Songyang-W/GridTapeStage_Scatha/docs/pinouts.xlsx

Sheet: DB-9 pinouts
 | Pin Number | Signal | Stepper wire | Shield Input | Shield | Shield Signal | CS | Chain Index | 0 direction | Enclosure Port
Top DB-9 | 1 | Feed, Pinch | Red | ST2 | Top | 2B | A2 | 0 | CCW | Top
 | 2 | Feed, Pinch | Blue | ST2 | Top | 1B | A2 | 0 | CCW | Top
 | 3 | Feed, Pinch | Black | ST2 | Top | 1A | A2 | 0 | CCW | Top
 | 4 | Feed, Pinch | Green | ST2 | Top | 2A | A2 | 0 | CCW | Top
 | 5 | NC
 | 6 | Feed, Reel | Red | ST2 | Bottom | 2B | D2 | 0 | CCW | Top
 | 7 | Feed, Reel | Blue | ST2 | Bottom | 1B | D2 | 0 | CCW | Top
 | 8 | Feed, Reel | Black | ST2 | Bottom | 1A | D2 | 0 | CCW | Top
 | 9 | Feed, Reel | Green | ST2 | Bottom | 2A | D2 | 0 | CCW | Top
Bottom DB-9 | 1 | Pickup, Pinch | Red | ST1 | Top | 2B | A2 | 1 | CCW | Bottom
 | 2 | Pickup, Pinch | Blue | ST1 | Top | 1B | A2 | 1 | CCW | Bottom
 | 3 | Pickup, Pinch | Black | ST1 | Top | 1A | A2 | 1 | CCW | Bottom
 | 4 | Pickup, Pinch | Green | ST1 | Top | 2A | A2 | 1 | CCW | Bottom
 | 5 | NC
 | 6 | Pickup, Reel | Red | ST1 | Bottom | 2B | D2 | 1 | CCW | Bottom
 | 7 | Pickup, Reel | Blue | ST1 | Bottom | 1B | D2 | 1 | CCW | Bottom
 | 8 | Pickup, Reel | Black | ST1 | Bottom | 1A | D2 | 1 | CCW | Bottom
 | 9 | Pickup, Reel | Green | ST1 | Bottom | 2A | D2 | 1 | CCW | Bottom

Sheet: 4 pin pinouts
 | Pin number | Signal | Buckpuck | Arduino | Load cell | Lemo Pin | Lemo Color
Left 4 pin | 1 | E+ |  |  | Red | 9 | Grey
(above USB) | 2 | E- |  |  | Black | 8 | Violet
 | 3 | A- |  |  | White | 7 | Blue
 | 4 | A+ |  |  | Green | 10 | White
Right 4 pin | 1 | 12V | V+ | -
 | 2 | 5V | REF
 | 3 | D3 | CTL | D3
 | 4 | GND | V- | GND

Sheet: 10pin Lemo
Pin | Wire color | Signal | Load Cell | 4 Pin connector
1 | Black
2 | Brown
3 | Red
4 | Orange
5 | Yellow
6 | Green
7 | Blue | A- | White | 3
8 | Violet | GND (E-) | Black | 2
9 | Gray | 5V (E+) | Red | 1
10 | White | A+ | Green | 4
