Songyang-W/GridTapeStage_Scatha/docs/BOM_191002.xlsx

Sheet: BOM
Part name | Quantity | CAD file | Drawing | Assembly | Type | Tested? | Info | Operation | Vender | Part Number | Quantity for 2 | Link | Package Cost | Units per package | Cost (for 1) | Packages for 2 | Cost | Ordered | When
chamber | 1 | chamber_v1 | chamber_v1 | piezo chamber | custom | yes | Al, 2 x 2.25 x 2.938 | machine |  |  | 2
chamber lid | 1 | chamber_lid_with_view | chamber_lid_with_view | piezo chamber | custom | yes | Al, 3/8 x 2 x 2.9063 | machine |  |  | 2
front left flange | 1 | front_left_xy_flange | front_left_xy_flange | piezo chamber | custom |  | Al, 1.6937 x 2 x 2.75 | machine |  |  | 2
piezo baseplate | 1 | piezo_baseplate | piezo_baseplate | piezo stack | custom | yes | Al, 0.049 x 0.669 x 1.181 | machine |  |  | 2
channel baseplate | 1 | channel_base_plate | channel_baseplate | piezo stack | custom | yes | Al, 0.0705 x 0.669 x 0.787 | machine |  |  | 2
load cell baseplate | 1 | load_cell_vertical_base_v2 | load_cell_vertical_base_v2 | tension sensor | custom | yes | Al, 0.295 x 0.570 x 0.875 | machine |  |  | 2
load cell adapter | 1 | tension_roller_mount_v2 | tension_roller_mount_v2 | tension sensor | custom | yes | Al, 0.25 x 0.5 x 0.647 | machine |  |  | 2
load cell rollers | 1 | tension_roller_v2 | tension_roller_v2 | tension sensor | custom | yes | Al, D0.25 x 0.5 | machine |  |  | 2
channel bottom | 1 | straight_stick_v2 | straight_stick_v2 | channel | custom | yes | Al, 1.575 x 0.6693 x 9.75 | machine |  |  | 2
tape clamp | 1 | tape_clamp | tape_clamp | channel | custom | yes | Al, 0.0787 x 0.315 x 9.75 | machine |  |  | 2
takeup reel flange | 1 | takeup_reel_flange | takeup_reel_flange | takeup | custom | yes | Al, 0.25 x 2.5 x 2.5 | machine |  |  | 2
takeup rest static insert | 1 | takeup_rest_insert | takeup_rest_insert | takeup | custom | yes | Al, D1.322 x 0.7874 | machine |  |  | 2
reel housing | 2 | reel_housing | reel_housing | reel housing | custom | yes | Al, 1.25 x 4.625 x 5.8956 | machine |  |  | 4
reel door | 2 | reel_door | reel_door | reel housing | custom | yes | Al, 0.25 x 4.625 x 5.8956 | machine |  |  | 4
reel flange | 2 | reel_housing_flange | reel_housing_flange | reel housing | custom | yes | Al, 0.25 x 2 x 2 | machine |  |  | 4
reel to qf flange | 2 | reel_housing_to_qf16_flange | reel_to_qf16_flange | reel housing | custom | yes | Al, 0.25 x 2 x 2 | machine |  |  | 4
reel blank flange | 4 | reel_housing_blank | reel_housing_blank | reel housing | custom | yes | Al, 0.25 x 1.25 x 2 | machine |  |  | 8
idle roller | 2 | roller | roller | reel housing | custom | yes | Al, D0.5 x 0.4478 | emachineshop |  |  | 4
pinch drive roller | 4 | drive_roller | drive_roller | pinch drive | custom | yes | Al, D0.82 x 0.315 | machine |  |  | 8
smaller pinch drive roller | 2 | drive_roller_smaller |  | pinch drive | custom | yes | Al, D0.81 x 0.315 | machine |  |  | 4
pinch drive plate | 2 | pinch_drive_clamp_short |  | pinch drive | custom | yes | Al, 0.125 x 1.1024 x 1.4824 | waterjet |  |  | 4
reel adapter | 2 | reel_adapter_screw_set_3f16 | reel_adapter_screw_set_3f16 | reel drive | custom | yes | Al, D1.675 x 0.5 | machine |  |  | 4
reel drive feedthrough clamp | 4 | ferrotec_clamp | ferrotec_clamp | reel drive | custom | yes | Al, 0.1875 x 1.1024 x 1.1024 | machine |  |  | 8
reel drive plate | 2 | reel_drive_clamp |  | reel drive | custom | yes | Al, 0.125 x 4.4973 x 5.167 | waterjet |  |  | 4
slip clutch shaft | 2 | shaft_adapter_5mm_1f4in | shaft_adapter_5mm_1f4in | reel drive | custom | yes | Al, D0.5 x 1 | machine |  |  | 4
takeup rest oring | 2 |  |  | takeup | oring |  | dash 122 | order | mcmaster | 9464K86 | 4 | http://www.mcmaster.com/#9464K86 | 11.63 | 50 | 0.2326 | 1 | 11.63
piezo chamber lid oring | 1 |  |  | piezo chamber | oring | yes | dash 036 | order | mcmaster | 9464K361 | 2 | http://www.mcmaster.com/#9464K361 | 4.75 | 10 | 0.475 | 1 | 4.75
front left to piezo oring | 1 |  |  | piezo chamber | oring |  | dash 027 | order | mcmaster | 9464K271 | 2 | http://www.mcmaster.com/#9464K271 | 10.76 | 50 | 0.2152 | 1 | 10.76
front left to scope oring | 1 |  |  | piezo chamber | oring |  | dash 028 | order | mcmaster | 9464K281 | 2 | http://www.mcmaster.com/#9464K281 | 10.49 | 50 | 0.2098 | 1 | 10.49
reel flange oring | 6 |  |  | reel housing | oring | yes | dash 027 | order | mcmaster | 9464K271 | 12 | http://www.mcmaster.com/#9464K271 | 10.76 | 50 | 0.2152 | 1 | 10.76
takeup flange oring | 1 |  |  | takeup | oring | yes | dash 219 | order | mcmaster | 9464K41 | 2 | http://www.mcmaster.com/#9464K41 | 11.25 | 25 | 0.45 | 1 | 11.25 |  |  | 92010A001
pinch drive oring | 4 |  |  | pinch drive | oring | yes | dash 018 square | order | mcmaster | 1170N29 | 8 | http://www.mcmaster.com/#1170N29 | 7.94 | 10 | 0.794 | 1 | 7.94 | 6448208 | 2016-03-22
reel housing door oring | 2 |  |  | reel housing | oring | yes | dash 048 | order | mcmaster | 9464K511 | 4 | http://www.mcmaster.com/#9464K511 | 2.23 | 2 | 1.115 | 2 | 4.46 | 6448208 | 2016-03-22
QF-25 clamp | 2 |  |  | piezo chamber | flange | yes |  | order | lesker | QF25-100-C | 4 | http://www.lesker.com/newweb/flanges/hardware_kf_clamps_machined.cfm?pgid=al2 | 8.25 | 1 | 8.25 | 4 | 33 | 6381132 | 160201
QF-25 centering ring | 3 |  |  | piezo chamber | flange | yes |  | order | lesker | QF25-100-SRV | 6 | http://www.lesker.com/newweb/flanges/hardware_kf_centeringrings.cfm?pgid=ss | 8.25 | 1 | 8.25 | 6 | 49.5 | 6381132 | 160201
QF-25 tee | 1 |  |  | piezo chamber | flange | yes |  | order | lesker | QF25-100-T | 2 | http://www.lesker.com/newweb/flanges/fittings_kf_tees.cfm?pgid=standardtee | 75 | 1 | 75 | 2 | 150 | 6381132 | 160201
QF-25 blank flange | 2 |  |  | piezo chamber | flange | yes |  | order | lesker | QF25-100-SB | 4 | http://www.lesker.com/newweb/flanges/flanges_kf_blank.cfm?pgid=flange1 | 9.3 | 1 | 9.3 | 4 | 37.2 | 6381132 | 160201
QF-25 bulkhead clamp | 1 |  |  | piezo chamber | flange | yes |  | order | lesker | QF25-100-BC | 2 | http://www.lesker.com/newweb/flanges/hardware_kf_clamps_bulkhead.cfm?pgid=al | 21.8 | 1 | 21.8 | 2 | 43.6 | 6381132 | 160201
QF-25 feedthrough (smaract) | 1 |  |  | piezo chamber | flange | yes |  | modify | lesker | QF25-100-SB | 2 | http://www.lesker.com/newweb/flanges/flanges_kf_blank.cfm?pgid=flange1 | 9.3 | 1 | 9.3 | 2 | 18.6 | 6381132 | 160201
QF-25 feedthrough (tension) | 1 |  |  | piezo chamber | flange | yes |  | modify | lesker | QF25-100-SB | 2 | http://www.lesker.com/newweb/flanges/flanges_kf_blank.cfm?pgid=flange1 | 9.3 | 1 | 9.3 | 2 | 18.6 | 6381132 | 160201
QF-16 viewport | 3 |  |  | reel housing | flange | yes |  | order | lesker | QF16-075-VP | 6 | http://www.lesker.com/newweb/flanges/viewports_kf_glass.cfm?pgid=0 | 100 | 1 | 100 | 6 | 600 | 6381132 | 160201
QF-16 blank | 3 |  |  | reel housing | flange | yes |  | order | lesker | QF16-075-SB | 6 | http://www.lesker.com/newweb/flanges/flanges_kf_blank.cfm?pgid=flange1 | 8.25 | 1 | 8.25 | 6 | 49.5 | 6381132 | 160201
QF-16 centering ring | 3 |  |  | reel housing | flange | yes |  | order | lesker | QF16-075-SRV | 6 | http://www.lesker.com/newweb/flanges/hardware_kf_centeringrings.cfm?pgid=ss | 6.5 | 1 | 6.5 | 6 | 39 | 6381132 | 160201
QF-16 bulkhead clamp | 3 |  |  | reel housing | flange | yes |  | order | lesker | QF16-075-BC | 6 | http://www.lesker.com/newweb/flanges/hardware_kf_clamps_bulkhead.cfm?pgid=al | 18.6 | 1 | 18.6 | 6 | 111.6 | 6381132 | 160201
tension sensor roller pin | 1 |  |  | tension sensor | fastener | yes | SS, 1/8 x 5/16 dowel pin | order | mcmaster | 90145A878 | 2 | http://www.mcmaster.com/#90145A878 | 7.34 | 50 | 0.1468 | 1 | 7.34
tension sensor adapter screws | 4 |  |  | tension sensor | fastener |  | SS, 0-80 x 1/4 FH | order | mcmaster | 91771A055 | 8 | http://www.mcmaster.com/#91771A055 | 9.01 | 100 | 0.0901 | 1 | 9.01
tension sensor mounting screws | 2 |  |  | tension sensor | fastener | yes | SS, 2-56 x 3/8 SHCS vented | order | mcmaster | 93235A079 | 4 | http://www.mcmaster.com/#93235A079 | 8.12 | 5 | 1.624 | 1 | 8.12 | 6448208 | 2016-03-22
piezo baseplate mounting screws | 4 |  |  | piezo chamber | fastener | yes | SS, 2-56 x 3/16 SHCS vented | order | mcmaster | 93235A076 | 8 | http://www.mcmaster.com/#93235A076 | 5.35 | 5 | 1.07 | 2 | 10.7 | 6448208 | 2016-03-22
piezo stack mounting screws | 4 |  |  | piezo chamber | fastener |  | SS, M1.6 x 4 mm FH | order | mcmaster | 91430A003 | 8 | http://www.mcmaster.com/#91430A003 | 8.7 | 25 | 0.348 | 1 | 8.7 | 6448208 | 2016-03-22
channel plate mounting screws | 2 |  |  | piezo chamber | fastener |  | SS, M2 x 3 mm FH | order | mcmaster | 92010A001 | 4 | http://www.mcmaster.com/#92010A001 | 4 | 100 | 0.04 | 1 | 4
channel mounting screws | 4 |  |  | channel | fastener |  | SS, 0-80 x 7/32 FH | order | mcmaster | 91771A040 | 8 | http://www.mcmaster.com/#91771A040 | 9.63 | 100 | 0.0963 | 1 | 9.63
front left to column screws | 4 |  |  | piezo chamber | fastener |  | SS, M6 x 10 SHCS low profile | order | mcmaster | 92855A610 | 8 | http://www.mcmaster.com/#92855A610 | 8.21 | 25 | 0.3284 | 1 | 8.21 | 6448208 | 2016-03-22
chamber to front left screws | 4 |  |  | piezo chamber | fastener |  | SS, M5 x 16 SHCS | order | mcmaster | 91292A126 | 8 | http://www.mcmaster.com/#91292A126 | 10 | 100 | 0.1 | 1 | 10
chamber lid screws | 4 |  |  | piezo chamber | fastener |  | SS, 6-32 x 1/2 FHSC | order | mcmaster | 92210A148 | 8 | http://www.mcmaster.com/#92210A148 | 4.36 | 100 | 0.0436 | 1 | 4.36
reel flange small screws | 16 |  |  | reel housing | fastener |  | SS, 4-40 x 3/8 FHSC | order | mcmaster | 92210A108 | 32 | http://www.mcmaster.com/#92210A108 | 3.35 | 100 | 0.0335 | 1 | 3.35 | 6448208 | 2016-03-22
reel flange large screws | 16 |  |  | reel housing | fastener |  | SS, 6-32 x 7/16 FHSC | order | mcmaster | 92210A114 | 32 | http://www.mcmaster.com/#92210A114 | 4.38 | 100 | 0.0438 | 1 | 4.38 | 6448208 | 2016-03-22
idle roller shoulder screw | 2 |  |  | pinch drive | fastener |  | SS, 4-40 x 1/8 x 5/8 shoulder screw | modify | mcmaster | 97345A104 | 4 | http://www.mcmaster.com/#97345A104 | 4.39 | 1 | 4.39 | 4 | 17.56 | 6448208 | 2016-03-22
pinch roller set screws | 4 |  |  | pinch drive | fastener |  | SS, 8-32 x 1/4 set screw vented | order | mcmaster | 91979A408 | 8 | http://www.mcmaster.com/#91979A408 | 7.1 | 10 | 0.71 | 1 | 7.1 | 6448208 | 2016-03-22
reel drive set screw | 2 |  |  | reel drive | fastener |  | SS, 8-32 x 1/4 set screw vented | order | mcmaster | 91979A408 | 4 | http://www.mcmaster.com/#91979A408 | 7.1 | 10 | 0.71 | 1 | 7.1 | 6448208 | 2016-03-22
reel hub screws | 6 |  |  | reel drive | fastener |  | SS, 2-56 x 1/2 SHCS | order | mcmaster | 92196A081 | 12 | http://www.mcmaster.com/#92196A081 | 5.72 | 100 | 0.0572 | 1 | 5.72 | 6448208 | 2016-03-22
reel door screws | 20 |  |  | reel housing | fastener | yes | SS, 4-40 x 3/8 SHCS | order | mcmaster | 92196A108 | 40 | http://www.mcmaster.com/#92196A108 | 3.98 | 100 | 0.0398 | 1 | 3.98 | 6448208 | 2016-03-22
ferrotec slamp screws | 16 |  |  | reel housing | fastener |  | SS, 2-56 x 5/16 FHSC | order | mcmaster | 92210A078 | 32 | http://www.mcmaster.com/#92210A078 | 6.22 | 100 | 0.0622 | 1 | 6.22
drive clamp screws | 6 |  |  | reel housing | fastener |  | SS, 4-40 x 3/8 SHCS | order | mcmaster | 92196A108 | 12 | http://www.mcmaster.com/#92196A108 | 3.98 | 100 | 0.0398 | 1 | 3.98 | 6448208 | 2016-03-22
nema 11 screws | 16 |  |  | reel housing | fastener | yes | SS, M2.5 x 6 BHSCS | order | mcmaster | 92095A458 | 32 | http://www.mcmaster.com/#92095A458 | 7.07 | 25 | 0.2828 | 2 | 14.14 | 6448208 | 2016-03-22
slip clutch set screws | 2 |  |  | reel drive | fastener |  | SS, 4-40 x 1/8 set screw | order | mcmaster | 92311A103 | 4 | http://www.mcmaster.com/#92311A103 | 4.21 | 100 | 0.0421 | 1 | 4.21 | 6448208 | 2016-03-22
takeup flange screws | 2 |  |  | takeup | fastener |  | SS, M4 x 10 FHSC | order | mcmaster | 92125A190 | 4 | http://www.mcmaster.com/#92125A190 | 7.23 | 100 | 0.0723 | 1 | 7.23
takeup flange wrench | 1 |  |  | takeup | tool |  | extended t-handle | order | mcmaster | 5334A42 | 2 | http://www.mcmaster.com/#5334A42 | 1.97 | 1 | 1.97 | 2 | 3.94 | 6448208 | 2016-03-22
stepper motors | 4 |  |  | motors | motors |  | nema 11 stepper | order | digikey | 1460-1072-ND | 8 | http://www.digikey.com/product-search/en?keywords=1460-1072-nd | 37.99 | 1 | 37.99 | 8 | 303.92 | 6390515 | 160208
tension sensor | 1 |  |  | tension sensor | sensor |  | 0-100g load cell | modify | phidgets | CZL639HD | 2 | http://www.phidgets.com/products.php?category=34&product_id=3139_0 | 7 | 1 | 7 | 2 | 14 | pcard | 160205
ferrotec feedthrough | 4 |  |  | reel housing | feedthrough | yes | rotary feedthroughs |  | ferrotec | 103073 | 8 | https://www.ferrotec.com/index.php?id=feedthrough_detail&vfp_id=34 | 600 | 1 | 600 | 8 | 4800 | 6382708 | 160202
piezo xy stack | 1 |  |  | piezo stack | motors |  | slc-1720-s-hv, in xy, with MCS | order | smaract | slc-1720-s-hv | 2 | http://smaract.de/index.php/products/slc17-positioners/slc-1720 | 9052.5 | 1 | 9052.5 | 2 | 18105 | 6382658 | 160202
load cell amplifier | 1 |  |  | electronics | electronics |  | load cell amplifier | modify | sparkfun | SEN-13230 | 2 | https://www.sparkfun.com/products/13230 | 9.95 | 1 | 9.95 | 2 | 19.9
microcontroller proto board | 1 |  |  | electronics | electronics |  | arduino protoshield | modify | sparkfun | DEV-11665 | 1 | https://www.sparkfun.com/products/11665 | 4.95 | 1 | 4.95 | 1 | 4.95
stepper motor driver shield | 2 |  |  | electronics | electronics |  | x-nucleo-ihm02a1 | modify | digikey | 497-16251-ND | 4 | https://punchout.digikey.com/scripts/DkSearch/dksus.dll?Detail&itemSeq=191838508&uq=635932000139947652 | 14.16 | 1 | 14.16 | 4 | 56.64 | 6432645 | 160310
power supply | 1 |  |  | electronics | electronics |  | 12V >3A supply | order | digikey | 237-1443-ND | 2 | http://www.digikey.com/product-detail/en/WSU120-3000/237-1443-ND/3094969 | 20.27 | 1 | 20.27 | 2 | 40.54 | 6390515 | 160208
power jack | 1 |  |  | electronics | electronics |  | barrel jack | modify | digikey | CP-065A-ND | 2 | http://www.digikey.com/product-search/en?keywords=CP-065A-ND | 2.54 | 1 | 2.54 | 2 | 5.08 | 6390515 | 160208
microcontroller | 1 |  |  | electronics | electronics |  | arduino | modify | digikey | 1050-1041-ND | 2 | http://www.digikey.com/product-detail/en/A000073/1050-1041-ND/3476357 | 21.54 | 1 | 21.54 | 2 | 43.08 | 6390515 | 160208
tension sensor cabling | 1 |  |  | electronics | electronics |  | 10 conductor wiring | modify | digikey | W410-50-ND | 1 | http://www.digikey.com/product-search/en?keywords=w410-50-nd | 64.63 | 1 | 64.63 | 1 | 64.63 | 6390515 | 160208
tension sensor feedthrough | 1 |  |  | electronics | electronics |  | lemo feedthrough | modify | mouser | 736-HGP2S310CLLPV | 2 | http://www.mouser.com/ProductDetail/LEMO/HGP2S310CLLPV/ | 102.14 | 1 | 102.14 | 2 | 204.28 | pcard | 160208
tension sensor connector | 1 |  |  | electronics | electronics |  | lemo plug | modify | mouser | 736-FFP2S310CLAC72Z | 2 | http://www.mouser.com/ProductDetail/LEMO/FFP2S310CLAC72Z/ | 70.11 | 1 | 70.11 | 2 | 140.22 | pcard | 160208
idle roller bearing | 4 |  |  | pinch drive | mechanics |  | 1/8 shaft 1/4 flanged bearing | order | mcmaster | 57155k205 | 8 | http://www.mcmaster.com/#57155K205 | 5.71 | 1 | 5.71 | 8 | 45.68 | 6448208 | 2016-03-22
pinch drive timing belt pulley | 2 |  |  | pinch drive | mechanics |  | 1/8 MXL 15 tooth 3/16 bore | modify | mcmaster | 1375K15 | 4 | http://www.mcmaster.com/#1375K15 | 9.81 | 1 | 9.81 | 4 | 39.24 | 6448208 | 2016-03-22
reel drive timing belt pulley | 1 |  |  | reel drive | mechanics |  | 1/8 MXL 15 tooth 3/16 bore | modify | mcmaster | 1375K15 | 2 | http://www.mcmaster.com/#1375K15 | 9.81 | 1 | 9.81 | 2 | 19.62 | 6448208 | 2016-03-22
slip clutch timing belt pulley | 1 |  |  | reel drive | mechanics |  | 1/8 MXL 20 tooth 1/4 bore | modify | mcmaster | 1375K21 | 2 | http://www.mcmaster.com/#1375K21 | 10.48 | 1 | 10.48 | 2 | 20.96 | 6448208 | 2016-03-22
pinch drive timing belt | 1 |  |  | pinch drive | mechanics |  | MXL 1/8" Width, 4" Outer Circle | order | mcmaster | 7887K12 | 2 | http://www.mcmaster.com/#7887K12 | 2.39 | 1 | 2.39 | 2 | 4.78 | 6448208 | 2016-03-22
reel drive timing belt | 1 |  |  | reel drive | mechanics |  | MXL 1/8" Width, 7.6" Outer Circle | order | mcmaster | 7887K19 | 2 | http://www.mcmaster.com/#7887K19 | 2.51 | 1 | 2.51 | 2 | 5.02 | 6448208 | 2016-03-22
slip clutch slip washers | 4 |  |  | reel drive | mechanics |  |  | order | mcmaster | 2797T1 | 8 | http://www.mcmaster.com/#2797T1 | 1.31 | 1 | 1.31 | 8 | 10.48 | 6448208 | 2016-03-22
slip clutch spring washers | 2 |  |  | reel drive | mechanics |  |  | order | mcmaster | 9714K28 | 4 | http://www.mcmaster.com/#9714K28 | 14.24 | 25 | 0.5696 | 1 | 14.24 | 6448208 | 2016-03-22
slip clutch shaft coller | 2 |  |  | reel drive | mechanics |  |  | order | mcmaster | 6157K12 | 4 | http://www.mcmaster.com/#6157K12 | 2.2 | 1 | 2.2 | 4 | 8.8 | 6448208 | 2016-03-22
tape camera | 1 |  |  | electronics | electronics |  | raspberry pi or m12 | order |  |  | 2 |  |  | 1 | 0 | 2 | 0
tape camera mount | 1 | picam_to_viewport_mount |  | tape camera | mechanics |  |  | 3d print |  |  | 2 |  | 0 | 1 | 0 | 2 | 0
light led | 1 |  |  | electronics | electronics |  |  | order | digikey |  | 2 |  |  | 1 | 0 | 2 | 0
light heatsink | 1 |  |  | electronics | electronics |  |  | order | digikey | 345-1105-ND | 2 | http://www.digikey.com/product-detail/en/882-100AB/345-1105-ND/2640528 | 2.34 | 1 | 2.34 | 2 | 4.68 | 6390515 | 160208
light driver | 1 |  |  | electronics | electronics |  |  | order | digikey | 788-1096-ND | 2 | http://www.digikey.com/product-detail/en/3021-D-I-700/788-1096-ND/3114413 | 16.99 | 1 | 16.99 | 2 | 33.98 | 6390515 | 160208
tc led mount | 1 | tc led mount |  |  | electronics |  |  | 3d print |  |  | 2 |  | 0 | 1 | 0 | 2 | 0
case | 1 |  |  | electronics | electronics |  |  | modify | digikey | HM856-ND | 2 | https://punchout.digikey.com/scripts/DkSearch/dksus.dll?Detail&itemSeq=193471005&uq=635950280810903346 | 7.94 | 1 | 7.94 | 2 | 15.88

Sheet: Piezo Chamber
Part name | Info | Quantity | CAD file | Modification? | Vender | Part Number | Link | Package Cost | Units per package | Cost (for 1) | Cost | Ordered | When
chamber | Sheet 2 1/2 x 3 x 4 Al | 1 | chamber_v1 | Yes | mcmaster |  |  |  | 1 |  | #VALUE! | Yes | 150326
chamber lid | Sheet 3/8 x 2 1/2 x 6 Al | 1 | chamber_lid_with_view | Yes | mcmaster |  |  |  | 2 |  | #VALUE! | Yes | 150326
piezo baseplate | Sheet 1/8 x 1 x 6 Al | 1 | piezo_baseplate | Yes | mcmaster | 8975K578 | http://www.mcmaster.com/#8975k578 | 0.86 | 3 | $0.29 | $0.29 | Yes | stock
load cell baseplate | Sheet 1/2 x 1/2 x 6 Al | 1 | load_cell_vertical_base_v2 | Yes | mcmaster | 9008K81 | http://www.mcmaster.com/#9008k81 | 1.48 | 6 | $0.25 | $0.25 | Yes | stock
load cell wall | Sheet 0.032 x 2 x 24 Al | 2 | load_cell_plate | Yes | mcmaster | 89015k151 | http://www.mcmaster.com/#89015k151 | 5.2 | 24 | $0.22 | $0.43 | Yes | stock
load cell adapter | Sheet 1/2 x 1/2 x 6 Al | 1 | load_cell_roller_mount_v2 | Yes | mcmaster | 9008K81 | http://www.mcmaster.com/#9008k81 | 1.48 | 6 | $0.25 | $0.25 | Yes | stock
idle roller | Rod 5/16 x 6 Al | 2 | tension_roller_v2 | Yes | mcmaster | 8974k23 | http://www.mcmaster.com/#8974k23 | 1.9 | 6 | $0.32 | $0.63 | Yes | 150326
 |  | 1 | front_left_xy_flange
takeup rest | Rod 1 3/16 x 6 Al | 1 | takeup_rest_insert | Yes | mcmaster | 8974k17 | http://www.mcmaster.com/#8974k17 | 10.26 | 3 | $3.42 | $3.42
 |  |  | takeup_rest_body
 |  |  | takeup_rest_slider
channel bottom | Sheet 3/4 x 1 x 12 Al | 1 | straight_stick_v2 | Yes | mcmaster | 8975k11 | http://www.mcmaster.com/#8975k11 | 5.14 | 1 | $5.14 | $5.14 | Yes | 150401
 |  |  | channel_base_plate
channel top | Sheet 3/4 x 1 x 12 Al | 1 | tape_clamp | Yes | mcmaster | 8975k11 | http://www.mcmaster.com/#8975k11 | 5.14 | 1 | $5.14 | $5.14 | Yes | 150401
channel clamps | Shim 0.005 SS | 1 |  | Yes | mcmaster |  |  |  |  |  | #VALUE! | Yes | stock
-- fasteners -- |  |  |  |  |  |  |  |  |  |  | #VALUE!
tension roller pin
chamber mounting screws | M5 x 16 | 4 |  |  | mcmaster | 91292a126 | http://www.mcmaster.com/#91292a126 | 10 | 100 | $0.10 | $0.40 | Yes | stock
chamber lid screws | #6 x 1/2 fhsc | 4 |  |  | mcmaster | 92210a148 | http://www.mcmaster.com/#92210a148 | 4.92 | 100 | $0.05 | $0.20 | Yes | 150326
piezo baseplate screws | 2-56 x 3/16 sc vented | 4 |  |  | mcmaster | 93235a076 | http://www.mcmaster.com/#93235a076 | 5.35 | 5 | $1.07 | $4.28 | Yes | 150326
load cell wall screws | 0-80 x 1/8 sc | 4 |  | Yes | mcmaster | 92210a010 | http://www.mcmaster.com/#92210a010 | 4.58 | 50 | $0.09 | $0.37 | Yes | 150326
load cell base screws | 2-56 x 1/2 sc vented | 2 |  |  | mcmaster | 93235a081 | http://www.mcmaster.com/#93235a081 | 14.07 | 5 | $2.81 | $5.63 | Yes | stock
load cell adapter screws | 0-80 x 1/4 sc | 4 |  | Yes | mcmaster | 90585a017 | http://www.mcmaster.com/#90585a017 | 7.51 | 12 | $0.63 | $2.50 | Yes | 150326
channel mount screws | M2 x 3 fhsc | 2 |  |  | mcmaster | 93395a135 | http://www.mcmaster.com/#93395a135 | 4.6 | 25 | $0.18 | $0.37 | Yes | 150401
channel clamp screws | 0-80 x 1/16 sc | 4 |  | Yes | mcmaster | 92196a047 | http://www.mcmaster.com/#92196a047 | 8.35 | 50 | $0.17 | $0.67 | Yes | 150401
-- orings -- |  |  |  |  |  |  |  |  |  |  | #VALUE!
takeup rest oring | dash 123 |  |  |  | mcmaster | 9464k87 | http://www.mcmaster.com/#9464k87 | 6.6 | 25 | $0.26 | $0.00
chamber lid oring | dash 036 | 1 |  |  | mcmaster | 9464k361 | http://www.mcmaster.com/#9464k361 | 4.75 | 10 | $0.47 | $0.47 | Yes | 150326
front port coupler oring | dash 028
-- misc -- |  |  |  |  |  |  |  |  |  |  | #VALUE!
piezo xy plate |  |  |  |  |  |  |  |  |  |  | #VALUE!
load cell |  |  |  |  |  |  |  |  |  |  | #VALUE!
-- vacuum flanges -- |  |  |  |  |  |  |  |  |  |  | #VALUE!
QF-25 clamp |  |  |  |  |  |  |  |  |  |  | #VALUE!
QF-25 centering ring |  |  |  |  |  |  |  |  |  |  | #VALUE!
QF-25 blank flange |  |  |  |  |  |  |  |  |  |  | #VALUE!
QF-25 tee |  |  |  |  |  |  |  |  |  |  | #VALUE!
QF-25 bulkhead connector |  | 1 |  |  | lesker | QF25-100-BC | http://www.lesker.com/newweb/flanges/hardware_kf_clamps_bulkhead.cfm?pgid=al | 21.8 | 1 | $21.80 | $21.80
-- electronics -- |  |  |  |  |  |  |  |  |  |  | #VALUE!
Load cell |  | 1 |  |  | phidgets | CZL639HD |  | 7 | 1 | $7.00 | $7.00
Load cell amplifier |  | 1 |  |  | sparkfun | SEN-13230 |  | 9.95 | 1 | $9.95 | $9.95
Piezos |  |  | xy_slc-1720-s_v2 |  | smaract |  |  | 22454.73 | 1 | $22454.73 | $0.00

Sheet: Reel housing
Part name | Info | Quantity | CAD file | Modification? | Vender | Part Number | Link | Package Cost | Units per package | Cost (for 1) | Cost | Ordered | When
Housing | Sheet 1 1/2 x 6 x 12 Al | 1 | reel_housing | Yes | mcmaster | 8975K336 | http://www.mcmaster.com/#8975K336 | 79.17 | 2 | $39.59 | $39.59 | Yes | 150401
Door | Sheet 1/4 x 6 x 12 Al (flat) | 1 | reel_door | Yes | mcmaster | 3511t12 | http://www.mcmaster.com/#3511t12 | 52.19 | 2 | $26.09 | $26.09 | Yes | 150401
Reel flange | Sheet 1/4 x 2 x 12 Al (flat) | 1 | reel_housing_flange | Yes | mcmaster | 3511t111 | http://www.mcmaster.com/#3511t111 | 34.79 | 5 | $6.96 | $6.96 | Yes | 150326
Reel to qf flange | Sheet 1/4 x 2 x 12 Al (flat) | 1 | reel_housing_to_qf16_flange | Yes | mcmaster | 3511t111 | http://www.mcmaster.com/#3511t111 | 34.79 | 5 | $6.96 | $6.96 | Yes | 150326
Reel blank flange | Sheet 1/4 x 2 x 12 Al (flat) | 1 | reel_housing_blank | Yes | mcmaster | 3511t111 | http://www.mcmaster.com/#3511t111 | 34.79 | 8 | $4.35 | $4.35 | Yes | 150326
Idle roller | Rod 1/2 x 6 Al | 1 | roller | Yes | mcmaster | 8974k28 | http://www.mcmaster.com/#8974k28 | 2.3 | 6 | $0.38 | $0.38 | Yes | stock
Idle roller spacer | Rod 3/16 x 12 Al | 1 |  | Yes | mcmaster | 8974K21 | http://www.mcmaster.com/#8974K21 | 1.47 | 6 | $0.24 | $0.24 | Yes | 150326
Reel adapter | Rod 1 5/8 x 6 Al | 1 | reel_adapter_screw_set_3f16 | Yes | mcmaster | 8974k66 | http://www.mcmaster.com/#8974k66 | 13.12 | 6 | $2.19 | $2.19 | Yes | stock
Pinch driver roller | Rod 7/8 x 6 Al | 1 | drive_roller | Yes | mcmaster | 8974K12 | http://www.mcmaster.com/#8974K12 | 4.99 | 6 | $0.83 | $0.83 | Yes | stock
Pinch drive plate | Sheet 1/4 x 1 1/4 x 6 Al | 1 | pinch_drive_clamp | Yes | mcmaster | 8975K597 | http://www.mcmaster.com/#8975K597 | 2.21 | 2 | $1.10 | $1.10 | Yes | stock
 |  |  | reel_drive_clamp
Takeup reel flange | Sheet 5/16 x 3 x 6 Al | 1 | takeup_reel_flange | Yes | mcmaster | 8975k89 | http://www.mcmaster.com/#8975k89 | 5.96 | 4 | $1.49 | $1.49 | Yes | 150326
-- fasteners -- |  |  |  |  |  |  |  |  |  |  | #VALUE!
Reel guide shoulder screws | 4-40, 1/8 x 5/8 shoulder screw | 2 |  |  | mcmaster | 97345a104 | http://www.mcmaster.com/#97345a104 | 4.39 | 1 | $4.39 | $8.78 | Yes | stock
Ferrotec clamp screws | 2-56 x 1/4 fhsc | 8 |  |  | mcmaster | 92210a077 | http://www.mcmaster.com/#92210a077 | 6.72 | 100 | $0.07 | $0.54 | Yes | 150401
Reel flange clamp screws | 4-40 x 3/8 fhsc | 8 |  |  | mcmaster | 92210a108 | http://www.mcmaster.com/#92210a108 | 3.88 | 100 | $0.04 | $0.31 | Yes | 150326
Reel door clamp screws | 4-40 x sc | 10 |  |  | mcmaster | 92196a108 | http://www.mcmaster.com/#92196a108 | 4.12 | 100 | $0.04 | $0.41 | Yes | stock
Reel and drive set screws | 8-32 x 3/16 set screw vented | 4 |  |  | mcmaster | 91979a403 | http://www.mcmaster.com/#91979a403 | 6.61 | 10 | $0.66 | $2.64 | Yes | stock
Reel screws | 2-56 x 1/2 fhsc | 3 |  |  | mcmaster | 92210a081 | http://www.mcmaster.com/#92210a081 | 10.28 | 100 | $0.10 | $0.31 | Yes | 150326
Takeup flange screws | M4 x 10 fhsc | 2 |  |  | mcmaster | 92125a190 | http://www.mcmaster.com/#92125a190 | 7.23 | 100 | $0.07 | $0.14 | Yes | 150326
Reel plate mounting screw | #6 x 7/16 fhsc | 4 |  |  | mcmaster | 92210a114 | http://www.mcmaster.com/#92210a114 | 4.96 | 100 | $0.05 | $0.20 | Yes | 150401
-- orings -- |  |  |  |  |  |  |  |  |  |  | #VALUE!
Door oring | dash 048 | 1 |  |  | mcmaster | 9464k511 | http://www.mcmaster.com/#9464K511 | 2.23 | 2 | $1.11 | $1.11 | Yes | 150326
Reel flange oring | dash 027 | 3 |  |  | mcmaster | 9464k271 | http://www.mcmaster.com/#9464k271 | 10.76 | 50 | $0.22 | $0.65 | Yes | stock
Pinch drive oring | dash 018 square | 2 |  |  | mcmaster | 1170N29 | http://www.mcmaster.com/#1170N29 | 7.94 | 10 | $0.79 | $1.59 | Yes | 150326
Takeup flange oring | dash 219 | 1 |  |  | mcmaster | 9464k41 | http://www.mcmaster.com/#9464k41 | 11.25 | 25 | $0.45 | $0.45 | Yes | 150326
-- misc -- |  |  |  |  |  |  |  |  |  |  | #VALUE!
Idle roller bearing | 1/8 shaft 1/4 flanged bearing | 2 |  |  | mcmaster | 57155k205 | http://www.mcmaster.com/#57155k205 | 5.71 | 1 | $5.71 | $11.42 | Yes | stock
Pinch timing belt | MXL 1/8" Width, 4" Outer Circle | 1 |  |  | mcmaster | 7887K12 | http://www.mcmaster.com/#7887K12 | 2.39 | 1 | $2.39 | $2.39
Reel timing belt | MXL 1/8" Width, 7.6" Outer Circle | 1 |  |  | mcmaster | 7887K19 | http://www.mcmaster.com/#7887K19 | 2.51 | 1 | $2.51 | $2.51
Timing belt pulley | 1/8 MXL 15 tooth 3/16 bore | 3 |  |  | mcmaster | 1375K15 | http://www.mcmaster.com/#1375K15 | 9.81 | 1 | $9.81 | $29.43 | Yes | 150326
Slip clutch pulley
Slip clutch shaft collar
Slip clutch washers
Slip clutch spring washer
Slip clutch shaft
-- vacuum flanges -- |  |  |  |  |  |  |  |  |  |  | #VALUE!
QF-16 viewport |  | 1 |  |  | lesker | QF16-075-VP | http://www.lesker.com/newweb/flanges/viewports_kf_glass.cfm?pgid=0 | 100 | 1 | $100.00 | $100.00 | Yes | stock
QF-16 bulkhead connector |  | 1 |  |  | lesker | QF16-075-BC | http://www.lesker.com/newweb/flanges/hardware_kf_clamps_bulkhead.cfm?pgid=al | 18.6 | 1 | $18.60 | $18.60 | Yes | stock
QF-16 oring |  | 1 |  |  |  |  |  |  |  |  | #VALUE! | Yes | stock
QF-16 clamp |  |  |  |  |  |  |  |  |  |  |  | Yes | stock
-- electronics -- |  |  |  |  |  |  |  |  |  |  | #VALUE!
Stepper motors | nema 11 | 2 | nema11 |  | pololu | 1206 |  | 19.95 | 1 | $19.95 | $39.90 | Maybe
Camera |  | 1 |  |  | point grey |  |  | $1105 | 1 | $1105.00 | $1105.00
Motor drivers |  | 2 |  |  | sparkfun | BOB-11611 |  | 34.95 | 1 | $34.95 | $69.90
Microcontroller |  | 1 |  |  | sparkfun | DEV-11021 |  | 24.95 | 1 | $24.95 | $24.95
