Songyang-W/GridTapeStage_Scatha/hardware/parts/other/QF16-075-BC_1.sldasm

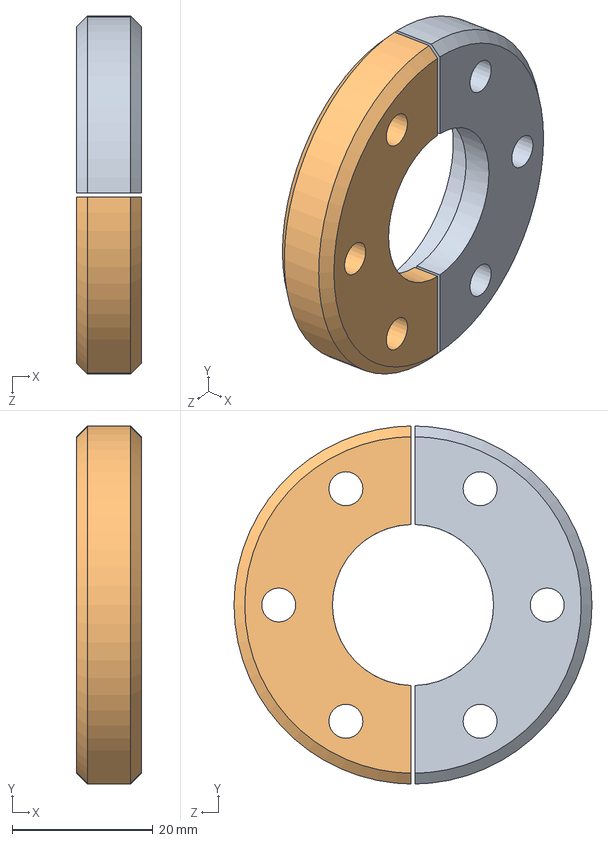
[picture p1: CAD file, 2022-06-01]
hardware/parts/other/QF16-075-BC_1.sldasm
9.17 x 50.8 x 50.8 mm
QF16-075-BC-R_2
QF16-075-BC-R_3
