Songyang-W/GridTapeStage_Scatha/hardware/parts/xy_v2.SLDASM

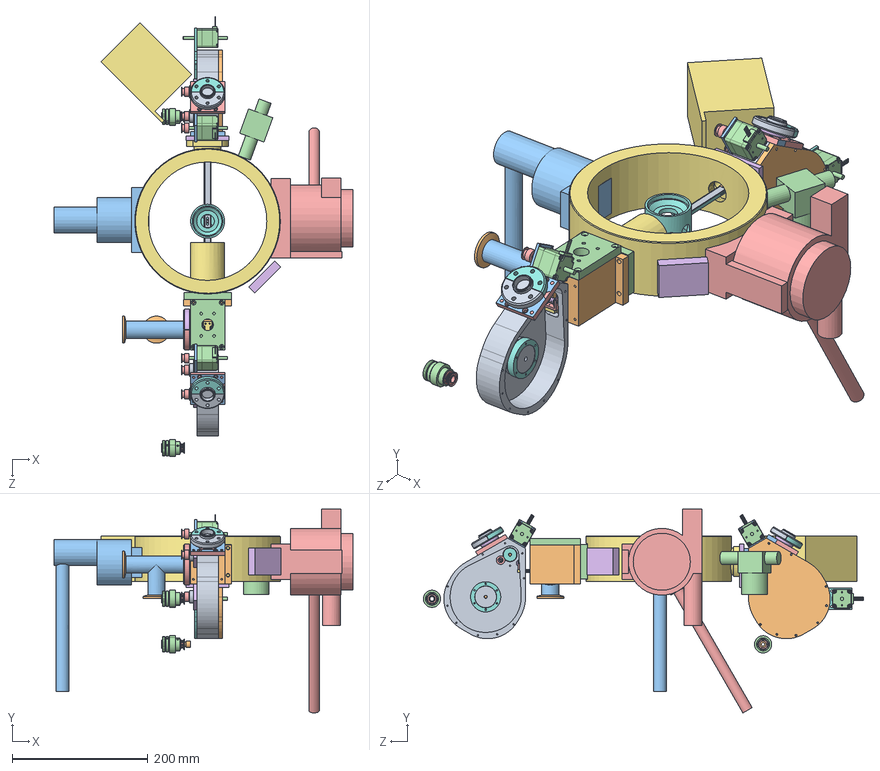
[picture p2: CAD file, 2022-06-01]
hardware/parts/xy_v2.SLDASM
440.1 x 300.2 x 648.0 mm
goniometer_2
right_side_solenoid
goniometer
aperture_objective_plate
JEOL 1200EX OL Module Rev. B
sap
Aperture blade
chamber_v1
piezo_baseplate
smaract_slc1720s x 2
XY_SLC-1720-s_V2
tension_roller_mount_v2
tension_roller_v2
100g_load_cell_RB-Phi-203
load_cell_vertical_base_v2
reel_hub x 2
101920 render x 4
116906 render x 4
101649 render x 4
100517 render x 4
drive_roller x 2
reel_housing x 2
roller x 2
57155K205 x 4
inner_spacer x 2
reel_housing_flange x 2
nema11 x 2
mxl_15t_3f16b_1375K15 x 6
ferrotec_clamp x 4
reel_adapter_screw_set_3f16 x 2
pinch_drive_clamp_short x 2
SI_sdpsi_s98ca6-mec160417 x 2
bandbmnfg_18mp012-6fa2 x 2
takeup_reel_flange
takeup_rest_insert
straight_stick_v2
tape_clamp
bent_spring_clamp x 3
spring_clamp
channel_base_plate
reel_housing_to_qf16_flange x 2
C0001197 x 2
P0001219 x 2
QF16-075-BC-R_2 x 2
QF16-075-BC-R_3 x 2
QF16-075-VP x 2
P0001498 x 3
P0017967
front_left_xy_flange
