Songyang-W/GridTapeStage_Scatha/hardware/parts/piezo_chamber.SLDASM

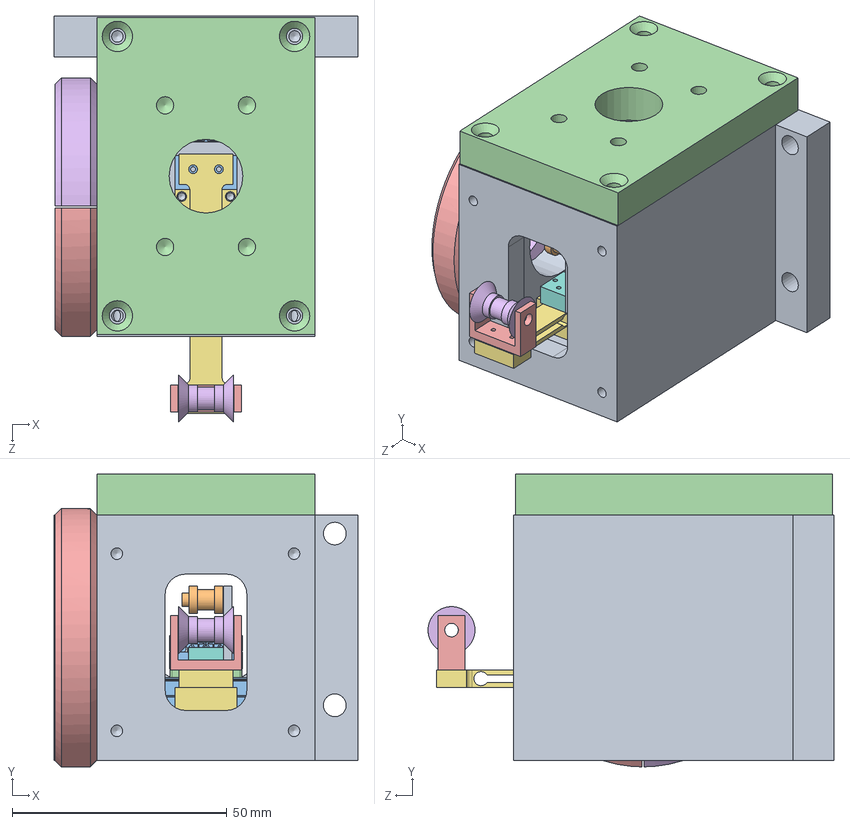
[picture p3: CAD file, 2022-06-01]
hardware/parts/piezo_chamber.SLDASM
70.8 x 68.2 x 94.6 mm
chamber_v1
piezo_baseplate
smaract_slc1720s x 2
XY_SLC-1720-s_V2
tension_roller_mount_v2
tension_roller_v2
100g_load_cell_RB-Phi-203
load_cell_vertical_base_v2
