Songyang-W/GridTapeStage_Scatha/hardware/parts/piezo_stack.SLDASM

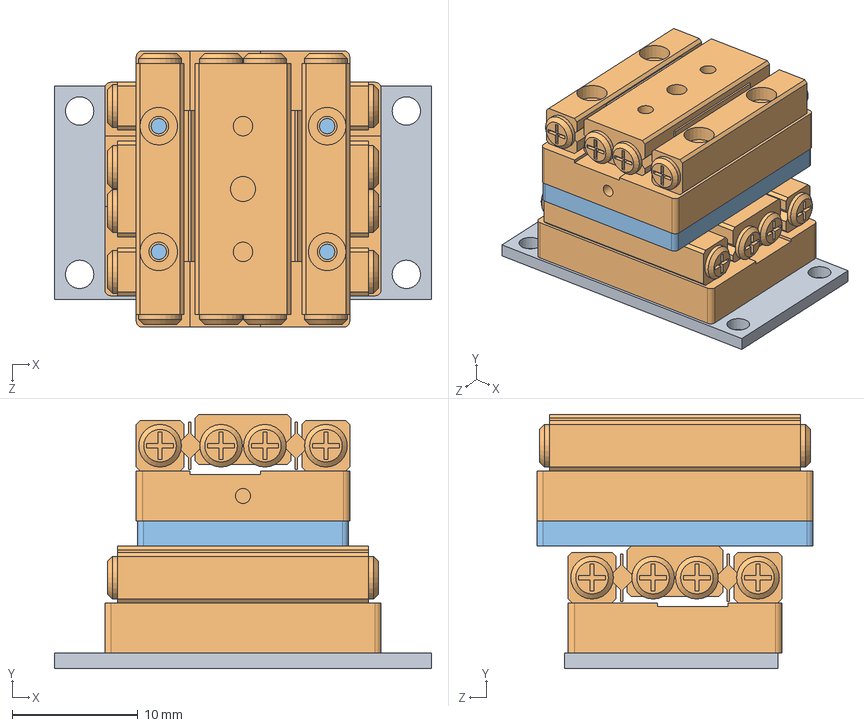
[picture p4: CAD file, 2022-06-01]
hardware/parts/piezo_stack.SLDASM
30.0 x 20.2 x 22.0 mm
piezo_baseplate
smaract_slc1720s x 2
XY_SLC-1720-s_V2
