Songyang-W/GridTapeStage_Scatha/hardware/parts/other/machined_roller_no_shaft.SLDASM

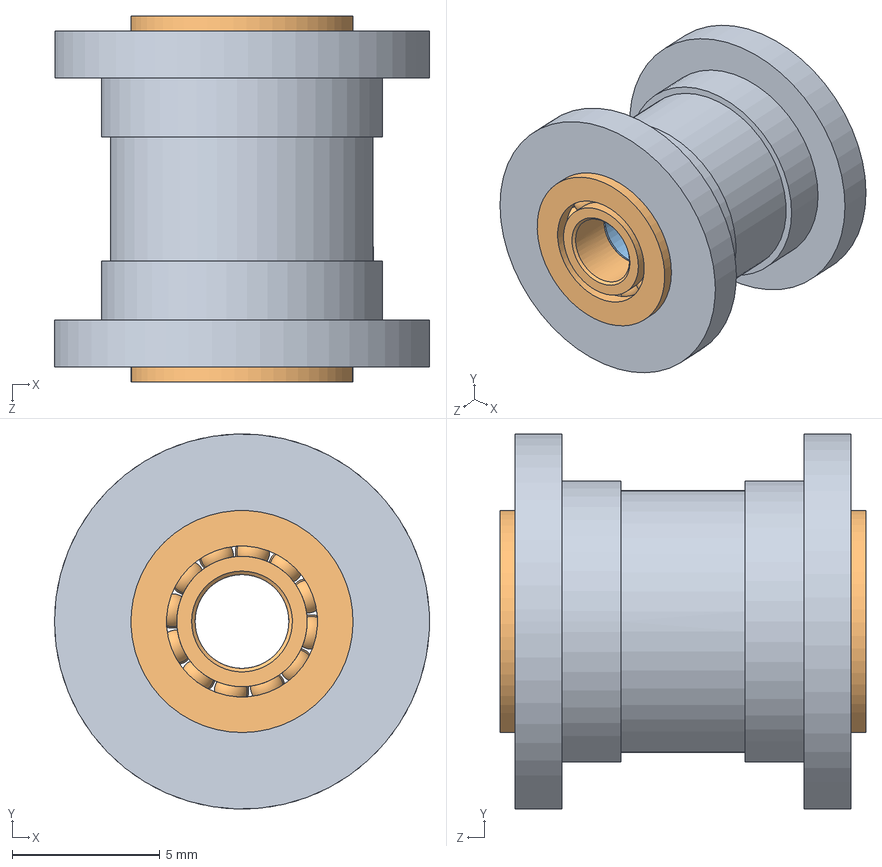
[picture p5: CAD file, 2022-06-01]
hardware/parts/other/machined_roller_no_shaft.SLDASM
12.7 x 12.7 x 12.4 mm
roller
57155K205 x 2
inner_spacer
