Songyang-W/GridTapeStage_Scatha/hardware/parts/other/reel_flange_qf16_feedthrough.SLDASM

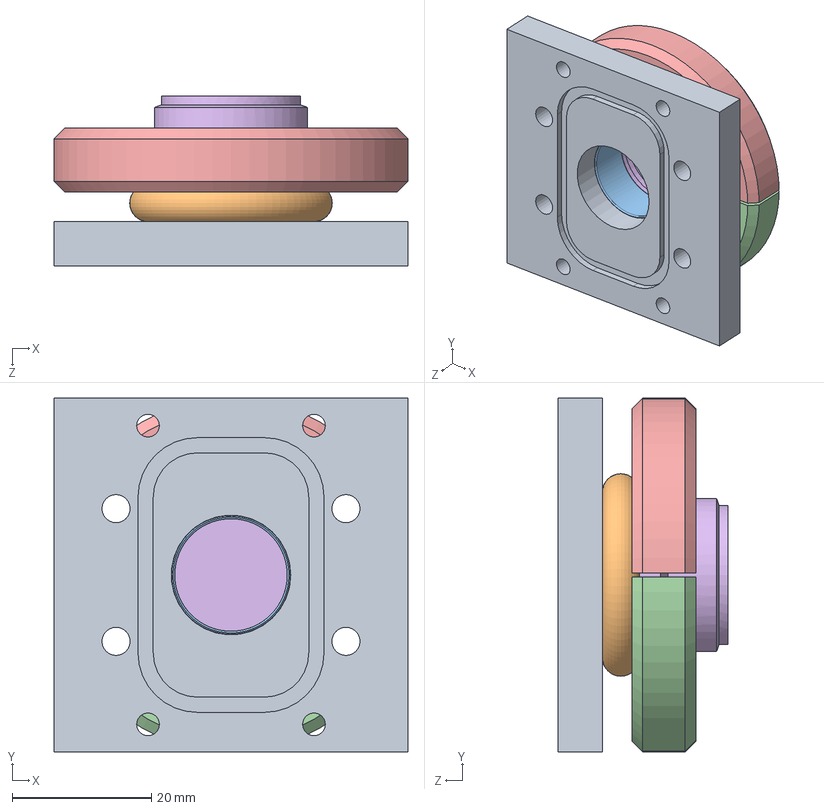
[picture p6: CAD file, 2022-06-01]
hardware/parts/other/reel_flange_qf16_feedthrough.SLDASM
50.8 x 50.8 x 24.4 mm
reel_housing_to_qf16_flange
C0001197
P0001219
QF16-075-BC-R_2
QF16-075-BC-R_3
QF16-075-VP
