Songyang-W/GridTapeStage_Scatha/hardware/parts/other/stick_assembly.SLDASM

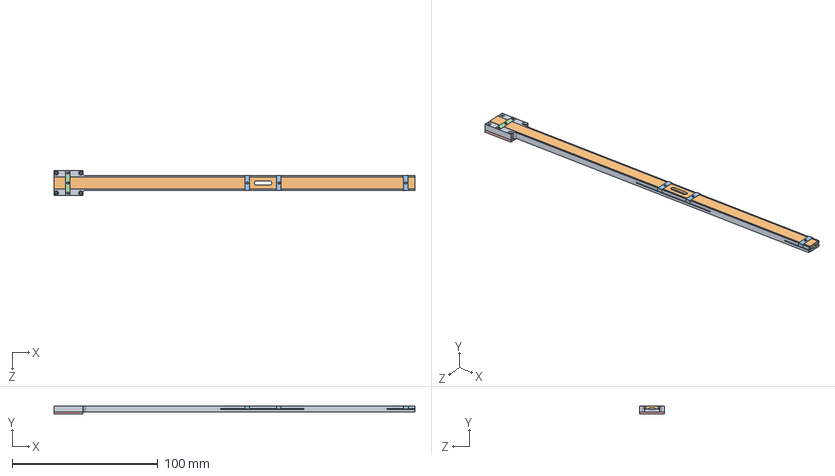
[picture p7: CAD file, 2022-06-01]
hardware/parts/other/stick_assembly.SLDASM
247.6 x 5.81 x 17.0 mm
straight_stick_v2
tape_clamp
bent_spring_clamp x 3
spring_clamp
channel_base_plate
