Songyang-W/GridTapeStage_Scatha/hardware/parts/tension_sensor_v2.SLDASM

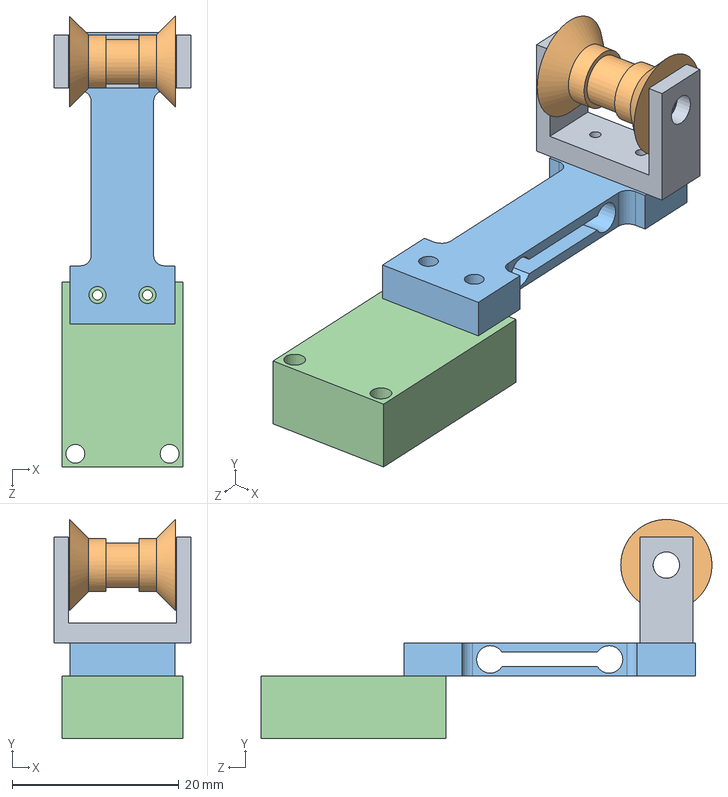
[picture p8: CAD file, 2022-06-01]
hardware/parts/tension_sensor_v2.SLDASM
16.4 x 26.3 x 54.1 mm
tension_roller_mount_v2
tension_roller_v2
100g_load_cell_RB-Phi-203
load_cell_vertical_base_v2
