Songyang-W/GridTapeStage_Scatha/hardware/parts/other/smaract_1720s_xy.SLDASM

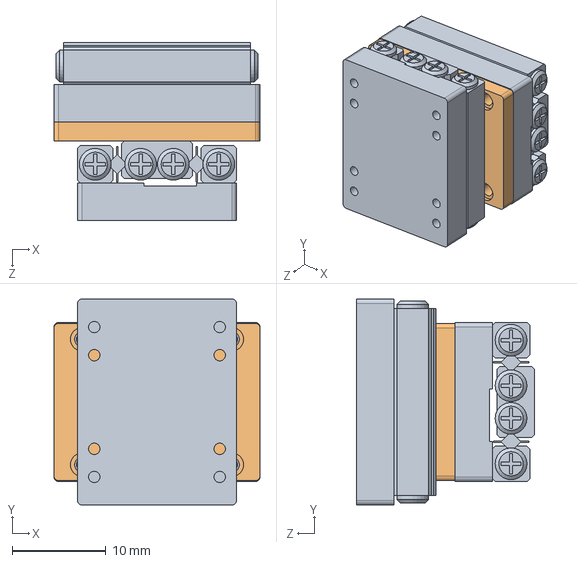
[picture p9: CAD file, 2022-06-01]
hardware/parts/other/smaract_1720s_xy.SLDASM
22.0 x 22.0 x 19.0 mm
smaract_slc1720s x 2
XY_SLC-1720-s_V2
