Songyang-W/GridTapeStage_Scatha/hardware/parts/other/QF16-075-ARB.sldasm

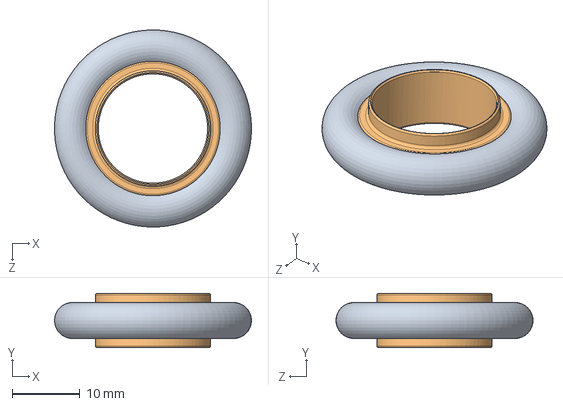
[picture p10: CAD file, 2022-06-01]
hardware/parts/other/QF16-075-ARB.sldasm
29.1 x 8.00 x 29.1 mm
C0001197
P0001219
