Songyang-W/GridTapeStage_Scatha/hardware/parts/other/vertical_load_cell.SLDASM

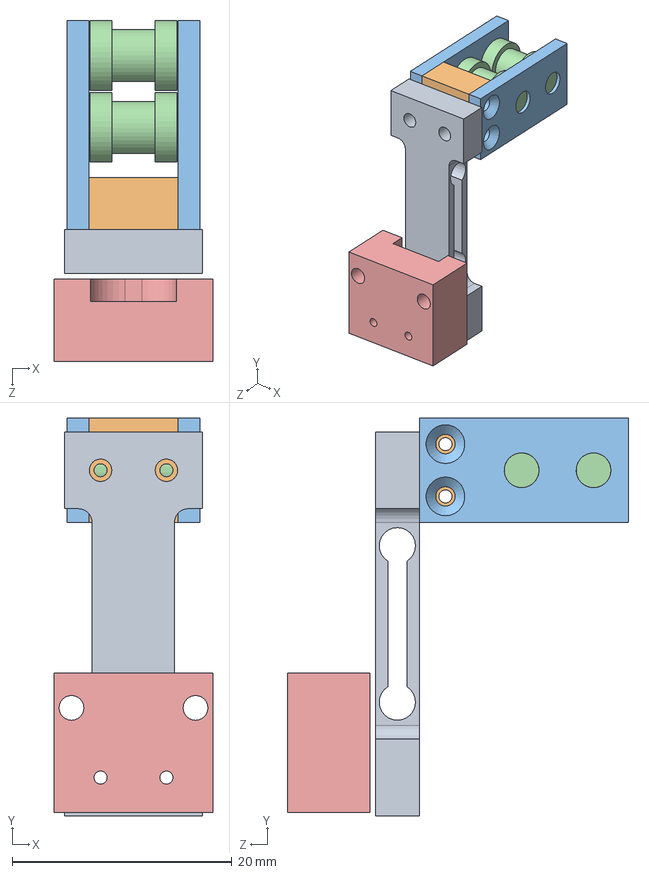
[picture p11: CAD file, 2022-06-01]
hardware/parts/other/vertical_load_cell.SLDASM
14.5 x 36.3 x 31.1 mm
100g_load_cell_RB-Phi-203
load_cell_vertical_adapter
load_cell_plate x 2
idle_roller_p25in x 2
load_cell_vertical_base
