Songyang-W/GridTapeStage_Scatha/hardware/parts/other/qf25-100-t.sldasm

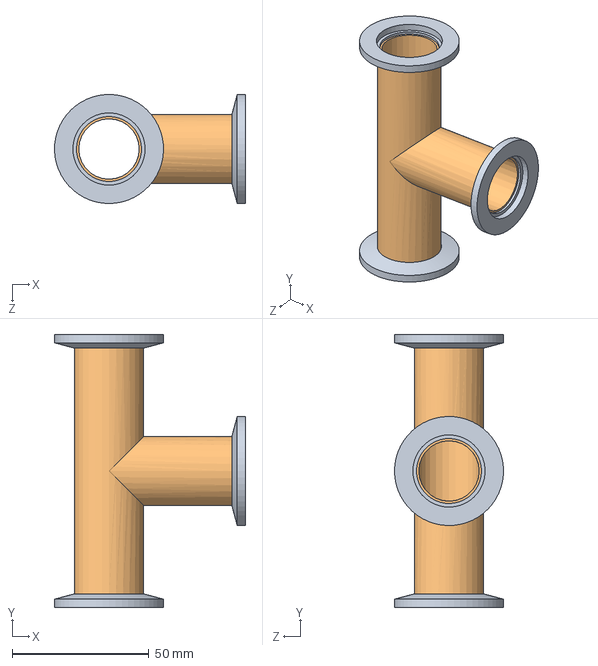
[picture p12: CAD file, 2022-06-01]
hardware/parts/other/qf25-100-t.sldasm
69.8 x 99.8 x 39.9 mm
P0001498 x 3
P0017967
