Songyang-W/GridTapeStage_Scatha/hardware/parts/other/qf25-100-bc (1).sldasm

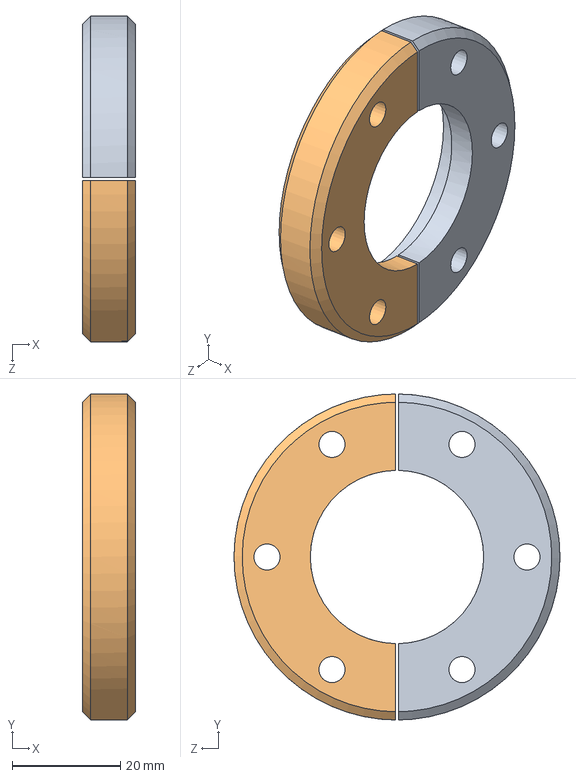
[picture p13: CAD file, 2022-06-01]
hardware/parts/other/qf25-100-bc (1).sldasm
9.83 x 60.2 x 60.2 mm
