Songyang-W/GridTapeStage_Scatha/hardware/parts/other/reel.SLDASM

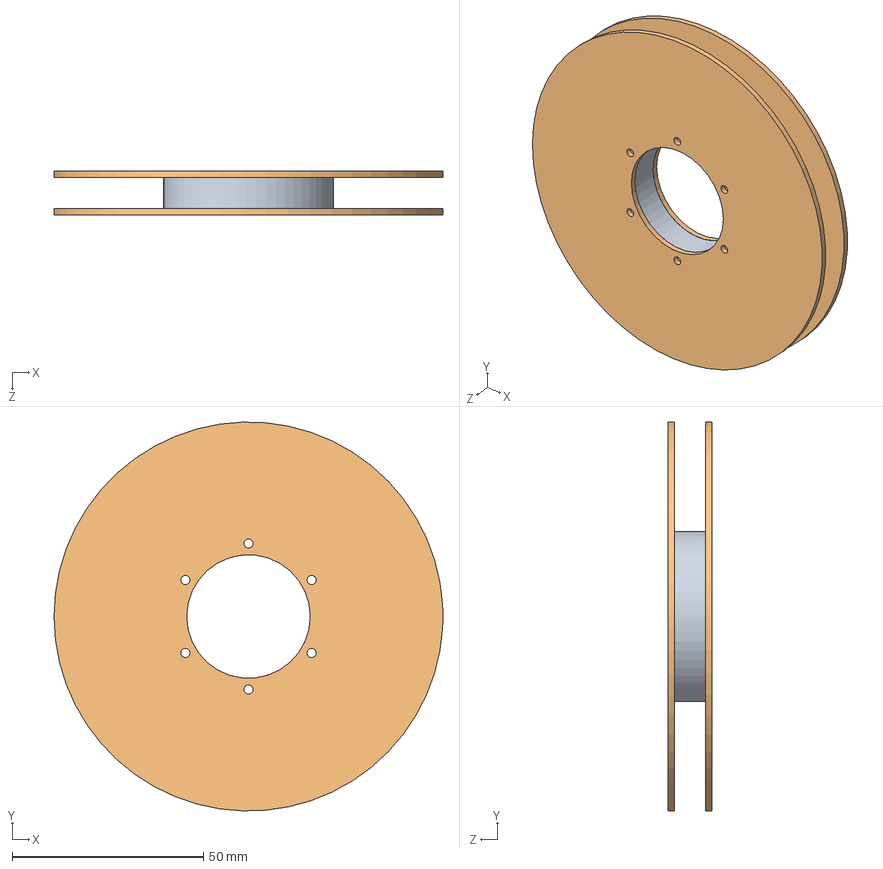
[picture p14: CAD file, 2022-06-01]
hardware/parts/other/reel.SLDASM
101.6 x 101.6 x 11.4 mm
reel_hub
reel_wall x 2
