Songyang-W/GridTapeStage_Scatha/hardware/parts/SI_sdpsi_s98ca6-mec160417.SLDPRT

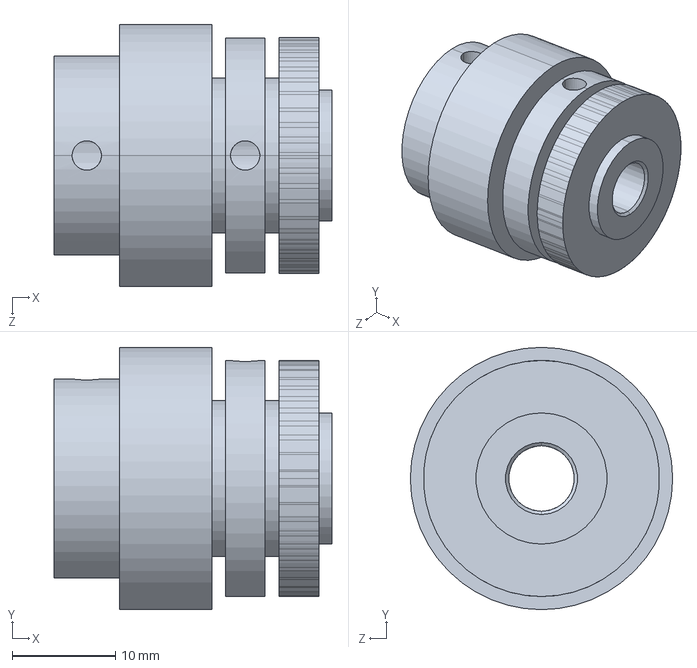
[picture p15: CAD file, 2022-06-21]
hardware/parts/SI_sdpsi_s98ca6-mec160417.SLDPRT
26.9 x 25.4 x 25.4 mm
