Songyang-W/GridTapeStage_Scatha/hardware/parts/other/XY_SLC-1720-s_V2.sldprt

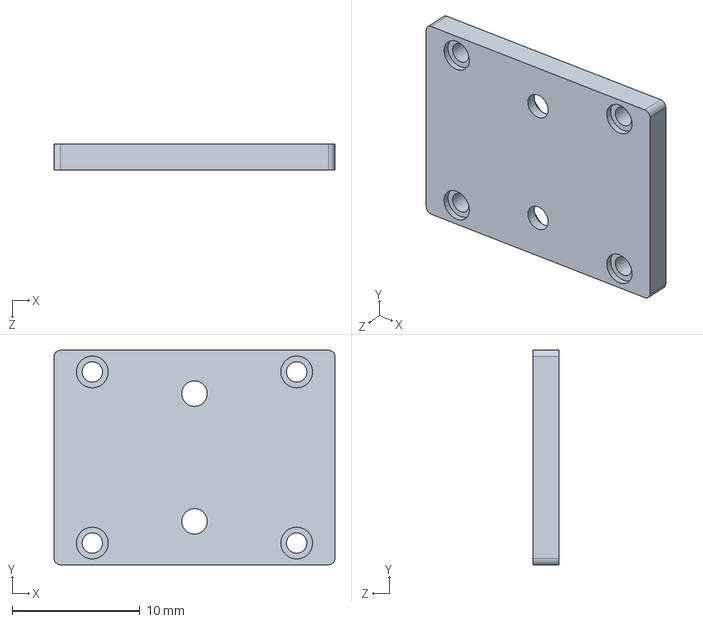
[picture p16: CAD file, 2022-06-01]
hardware/parts/other/XY_SLC-1720-s_V2.sldprt
22.0 x 16.8 x 2.00 mm
