Songyang-W/GridTapeStage_Scatha/hardware/parts/reel_housing_to_qf16_flange.STEP

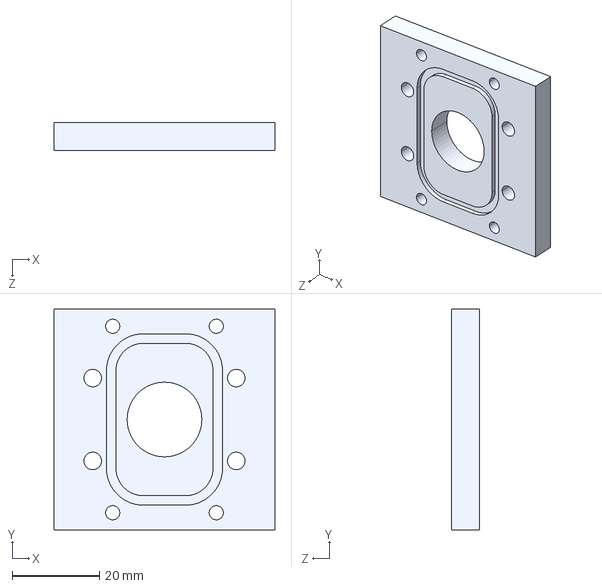
[picture p17: CAD file, 2022-06-01]
hardware/parts/reel_housing_to_qf16_flange.STEP
50.8 x 50.8 x 6.35 mm
