Songyang-W/GridTapeStage_Scatha/hardware/parts/other/smaract_slc1720s.SLDPRT

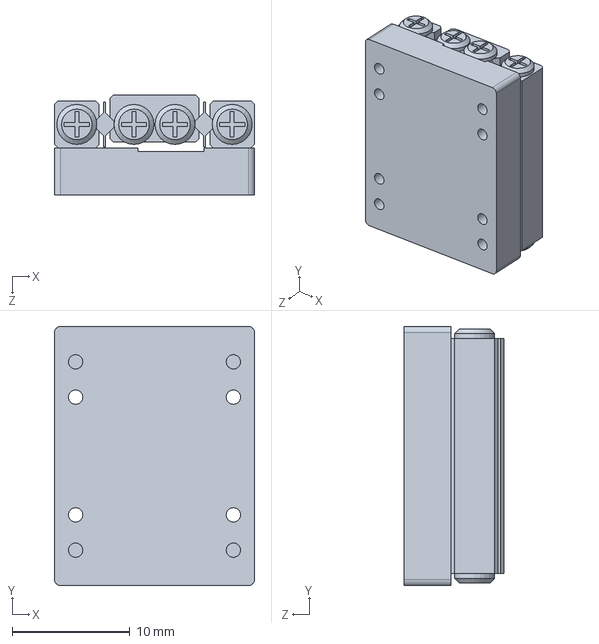
[picture p18: CAD file, 2022-06-01]
hardware/parts/other/smaract_slc1720s.SLDPRT
17.0 x 22.0 x 8.50 mm
