Songyang-W/GridTapeStage_Scatha/hardware/parts/reel_housing.SLDPRT

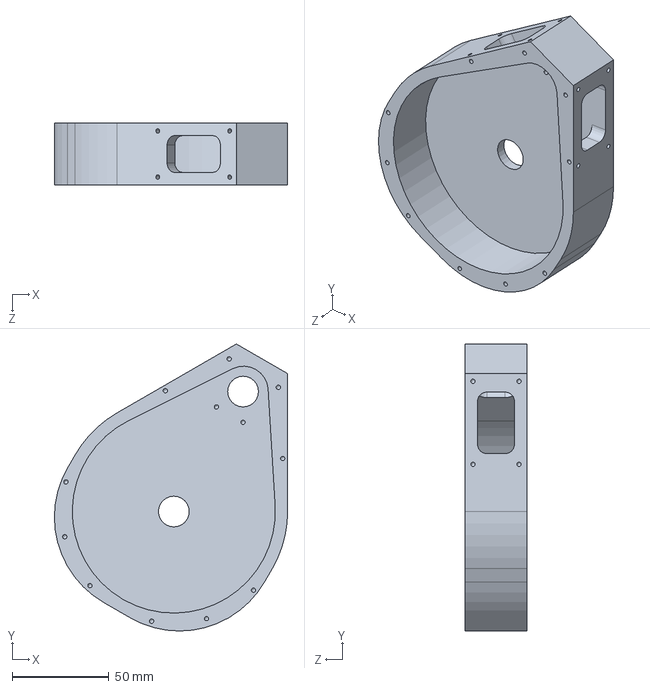
[picture p19: CAD file, 2022-06-01]
hardware/parts/reel_housing.SLDPRT
120.4 x 148.1 x 31.8 mm
