Songyang-W/GridTapeStage_Scatha/hardware/parts/reel_drive_clamp_test3.STEP

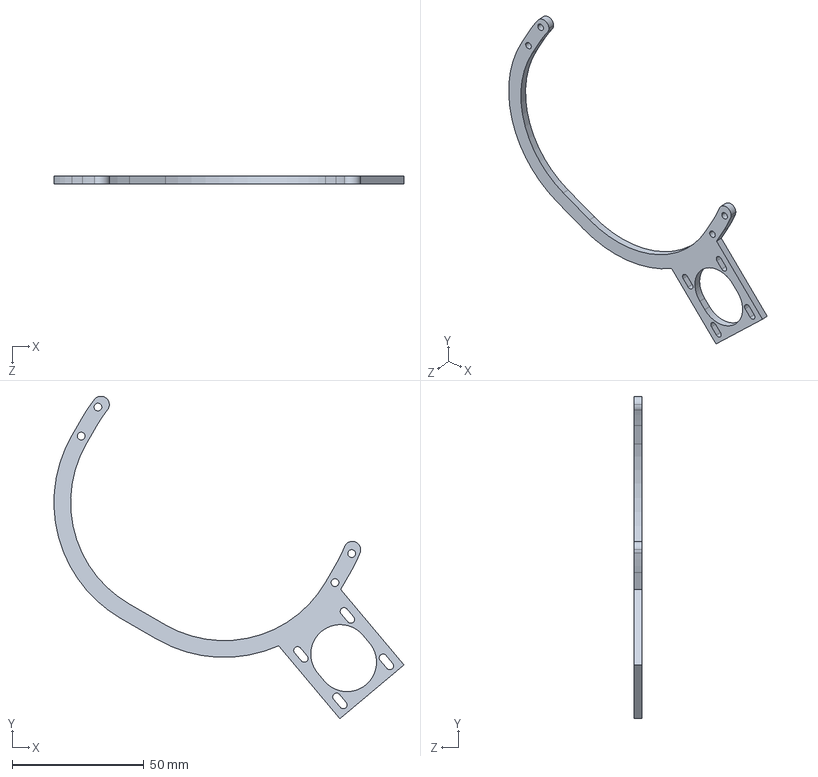
[picture p20: CAD file, 2022-06-01]
hardware/parts/reel_drive_clamp_test3.STEP
132.7 x 122.3 x 3.18 mm
