Songyang-W/GridTapeStage_Scatha/hardware/parts/tension_roller_v2.SLDPRT

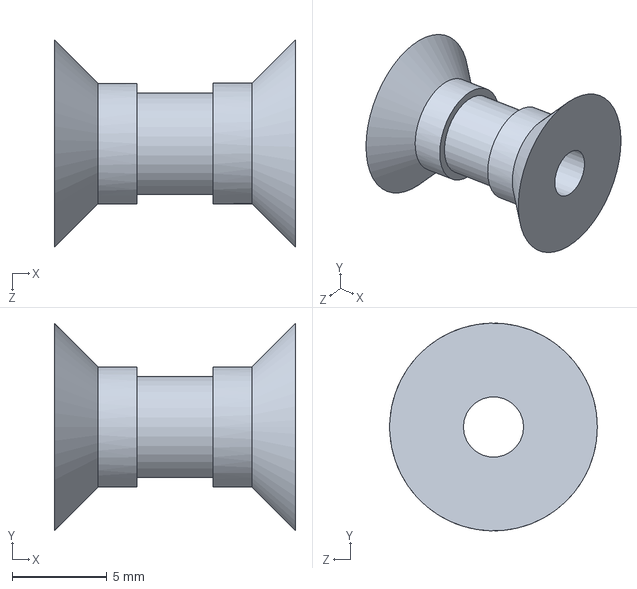
[picture p21: CAD file, 2022-06-01]
hardware/parts/tension_roller_v2.SLDPRT
12.7 x 10.9 x 10.9 mm
