Songyang-W/GridTapeStage_Scatha/hardware/parts/load_cell_vertical_base_v2.SLDPRT

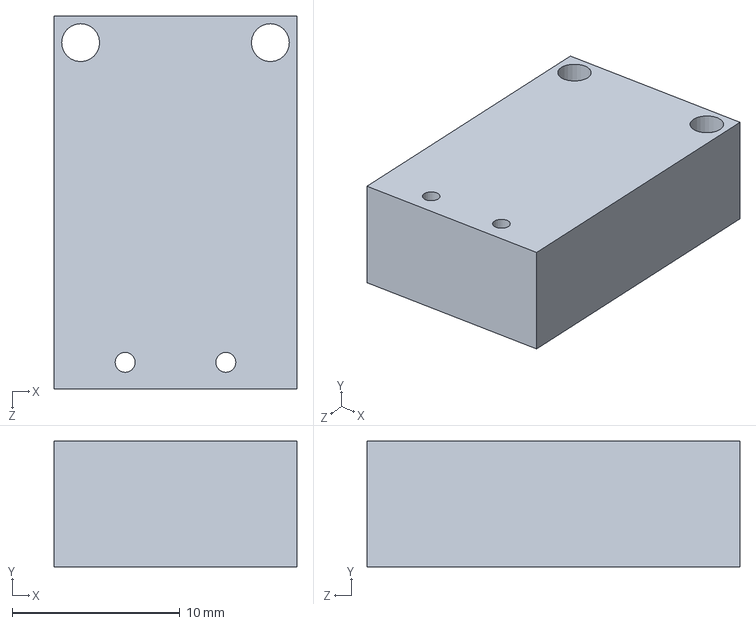
[picture p22: CAD file, 2022-06-01]
hardware/parts/load_cell_vertical_base_v2.SLDPRT
14.5 x 7.49 x 22.2 mm
