Songyang-W/GridTapeStage_Scatha/hardware/parts/other/reel_hub.SLDPRT

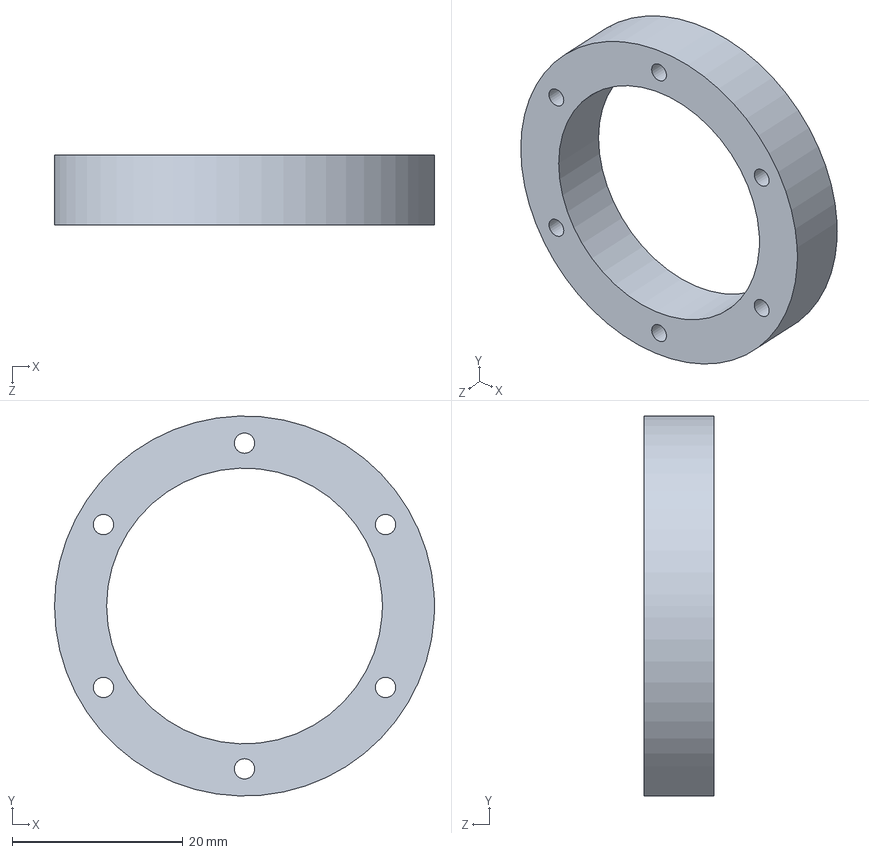
[picture p23: CAD file, 2022-06-01]
hardware/parts/other/reel_hub.SLDPRT
44.5 x 44.4 x 8.20 mm
