Songyang-W/GridTapeStage_Scatha/hardware/parts/reel_drive_clamp_test4.STEP

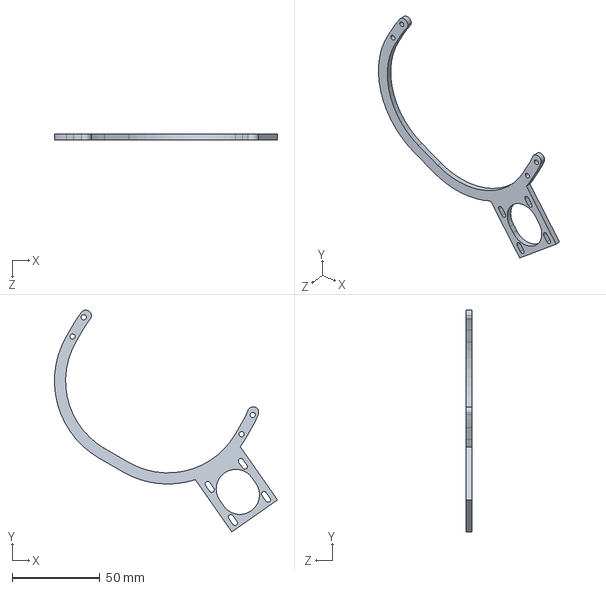
[picture p24: CAD file, 2022-06-01]
hardware/parts/reel_drive_clamp_test4.STEP
127.0 x 126.2 x 3.18 mm
