Songyang-W/GridTapeStage_Scatha/hardware/parts/other/bent_spring_clamp.SLDPRT

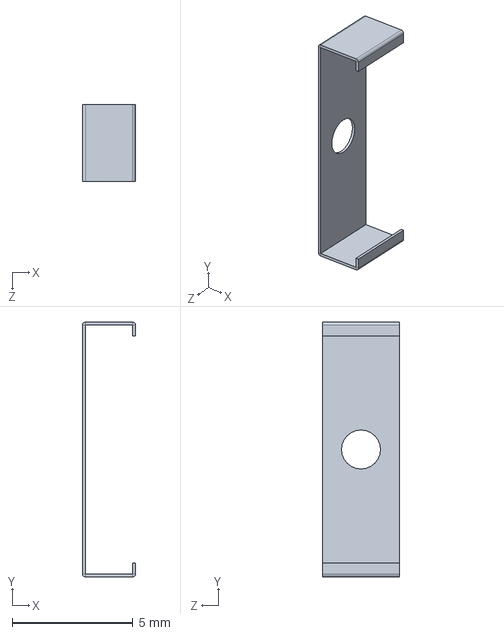
[picture p25: CAD file, 2022-06-01]
hardware/parts/other/bent_spring_clamp.SLDPRT
2.20 x 10.5 x 3.17 mm
