Songyang-W/GridTapeStage_Scatha/hardware/parts/pinch_drive_clamp_short.SLDPRT

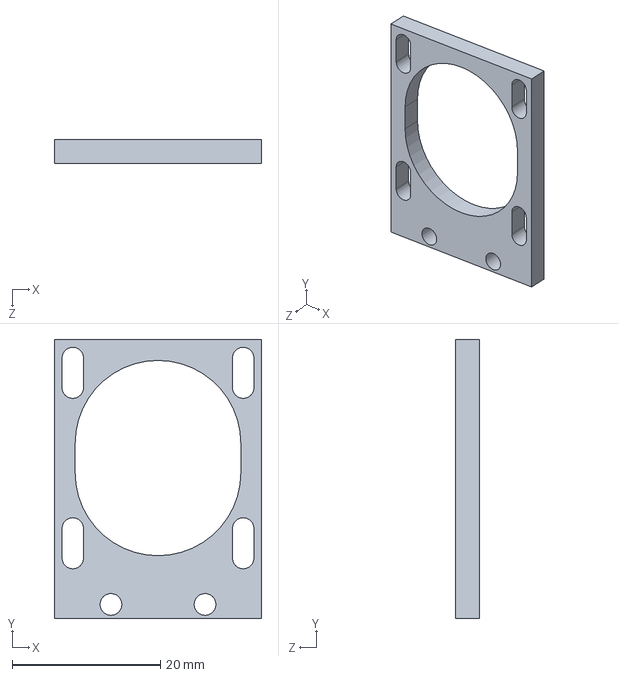
[picture p26: CAD file, 2022-06-01]
hardware/parts/pinch_drive_clamp_short.SLDPRT
28.0 x 37.7 x 3.17 mm
