Songyang-W/GridTapeStage_Scatha/hardware/parts/other/100g_load_cell_RB-Phi-203.SLDPRT

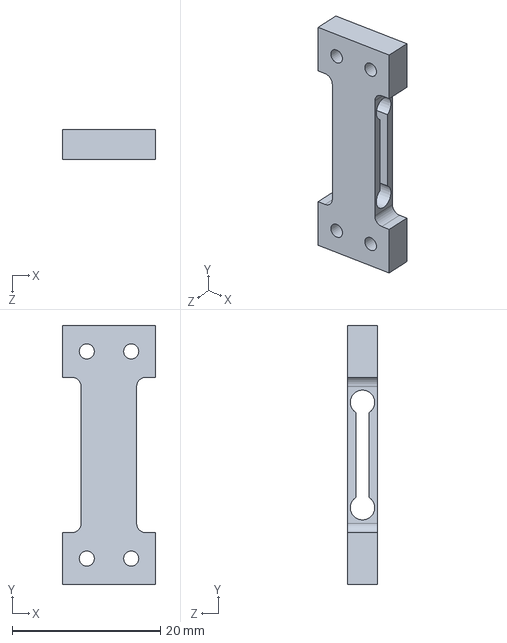
[picture p27: CAD file, 2022-06-01]
hardware/parts/other/100g_load_cell_RB-Phi-203.SLDPRT
12.5 x 35.0 x 4.00 mm
