Songyang-W/GridTapeStage_Scatha/hardware/parts/drive_roller.SLDPRT

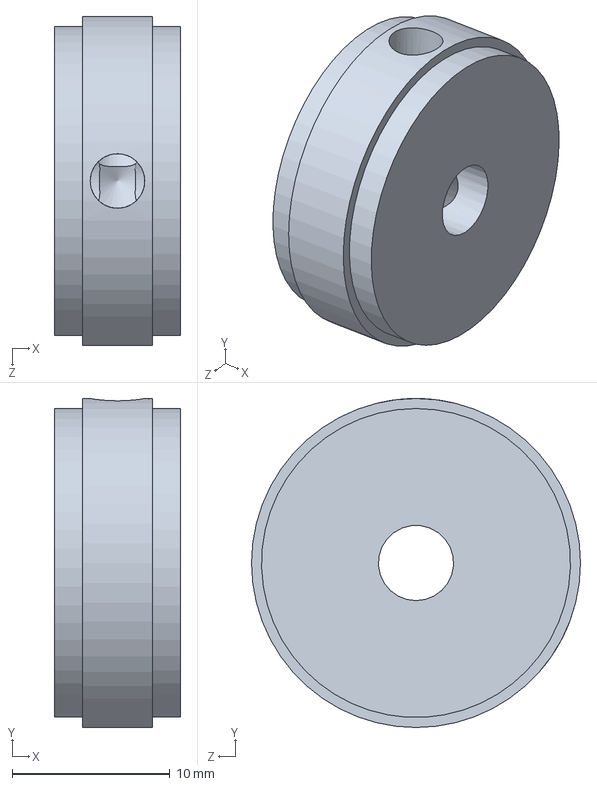
[picture p28: CAD file, 2022-06-01]
hardware/parts/drive_roller.SLDPRT
8.00 x 20.8 x 20.8 mm
