Songyang-W/GridTapeStage_Scatha/hardware/parts/other/load_cell_vertical_base.SLDPRT

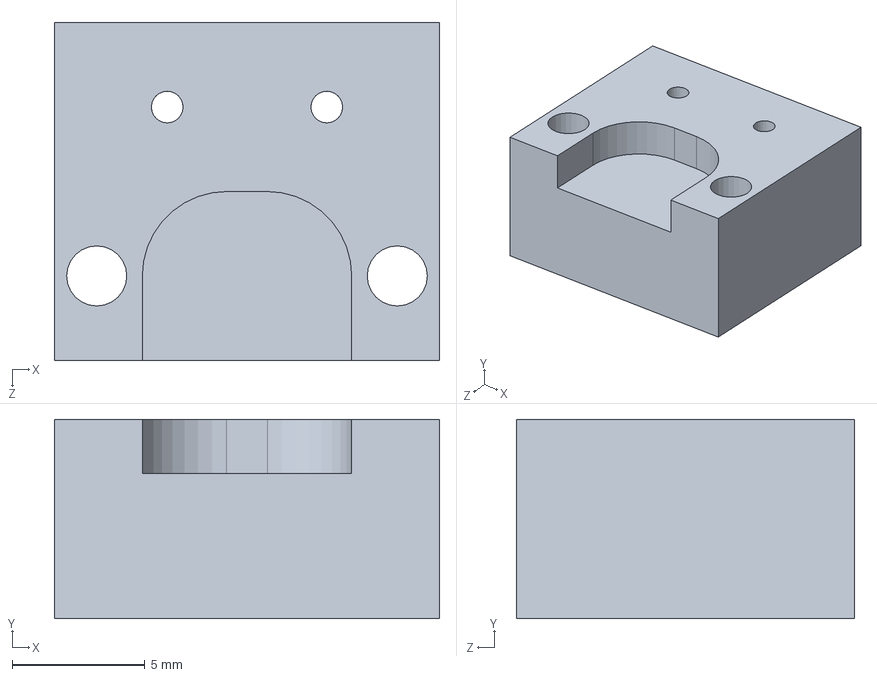
[picture p29: CAD file, 2022-06-01]
hardware/parts/other/load_cell_vertical_base.SLDPRT
14.5 x 7.49 x 12.7 mm
