Songyang-W/GridTapeStage_Scatha/hardware/parts/piezo_baseplate.SLDPRT

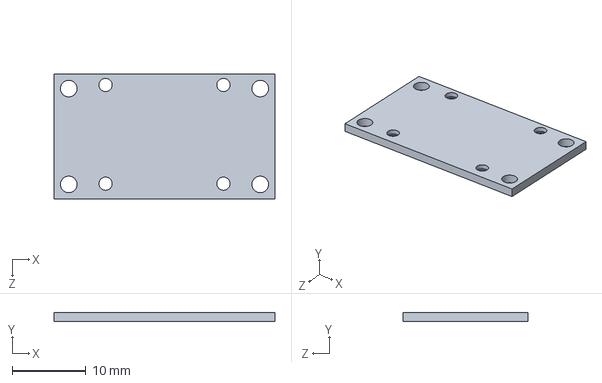
[picture p30: CAD file, 2022-06-01]
hardware/parts/piezo_baseplate.SLDPRT
30.0 x 1.24 x 17.0 mm
