Songyang-W/GridTapeStage_Scatha/hardware/parts/shaft_adapter_5mm_1f4in.STEP

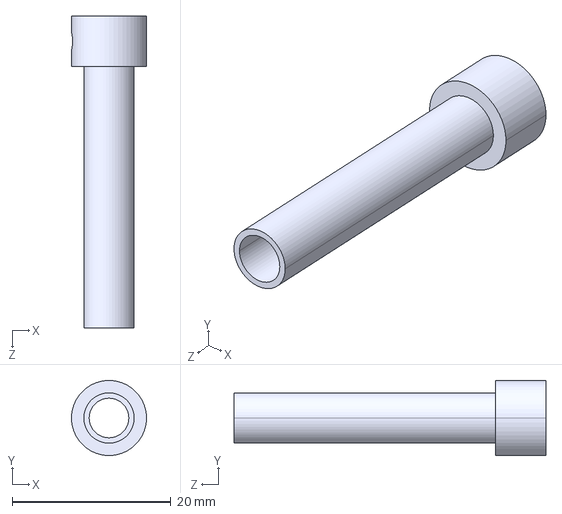
[picture p31: CAD file, 2022-06-01]
hardware/parts/shaft_adapter_5mm_1f4in.STEP
9.47 x 9.47 x 39.4 mm
