Songyang-W/GridTapeStage_Scatha/hardware/parts/other/load_cell_plate.SLDPRT

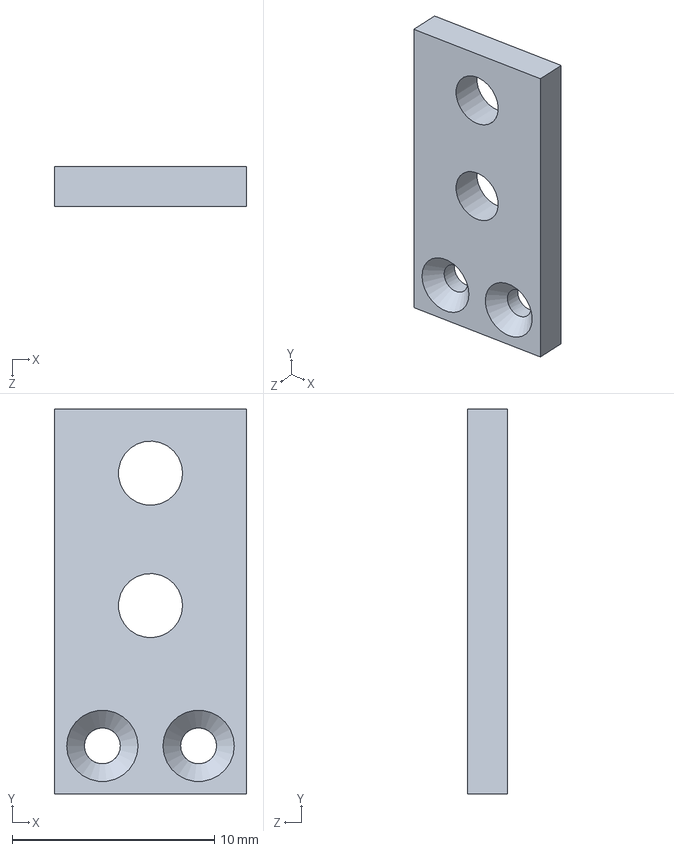
[picture p32: CAD file, 2022-06-01]
hardware/parts/other/load_cell_plate.SLDPRT
9.53 x 19.1 x 2.00 mm
