Songyang-W/GridTapeStage_Scatha/hardware/parts/reel_drive_clamp_test2.STEP

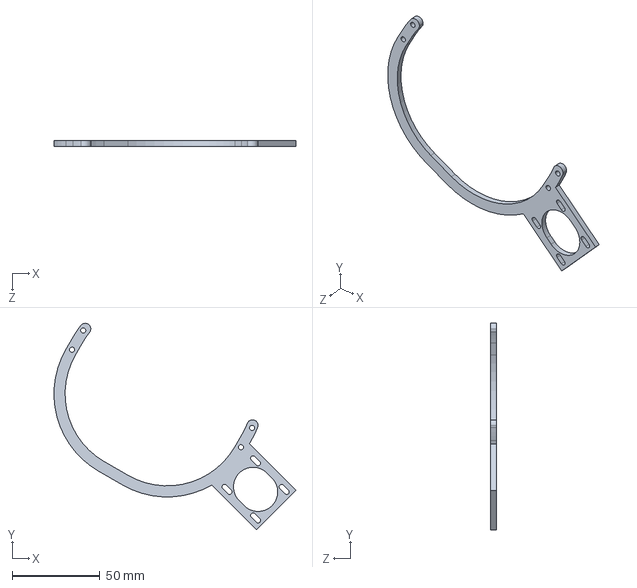
[picture p33: CAD file, 2022-06-01]
hardware/parts/reel_drive_clamp_test2.STEP
137.9 x 117.7 x 3.18 mm
