Songyang-W/GridTapeStage_Scatha/hardware/parts/other/QF16-075-VP.SLDPRT

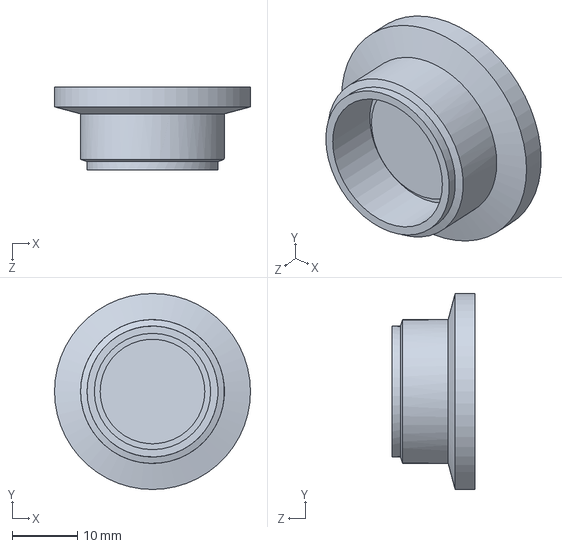
[picture p34: CAD file, 2022-06-01]
hardware/parts/other/QF16-075-VP.SLDPRT
30.0 x 30.0 x 12.7 mm
