Songyang-W/GridTapeStage_Scatha/hardware/parts/reel_drive_clamp.STEP

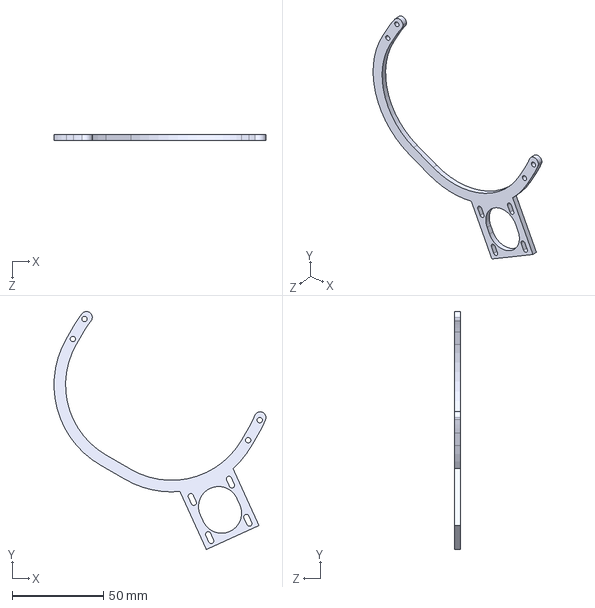
[picture p35: CAD file, 2022-06-01]
hardware/parts/reel_drive_clamp.STEP
116.3 x 130.6 x 3.18 mm
