Songyang-W/GridTapeStage_Scatha/hardware/parts/picam_to_viewport_mount.SLDPRT

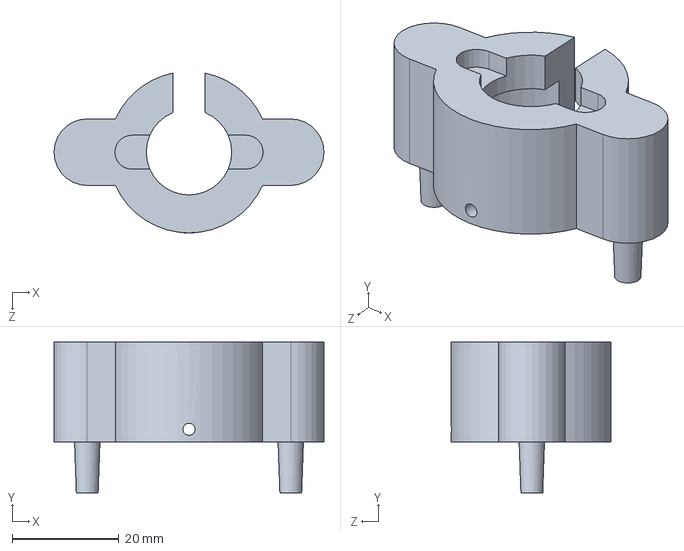
[picture p36: CAD file, 2022-06-01]
hardware/parts/picam_to_viewport_mount.SLDPRT
50.5 x 28.2 x 29.9 mm
