Songyang-W/GridTapeStage_Scatha/hardware/parts/reel_housing_blank.SLDPRT

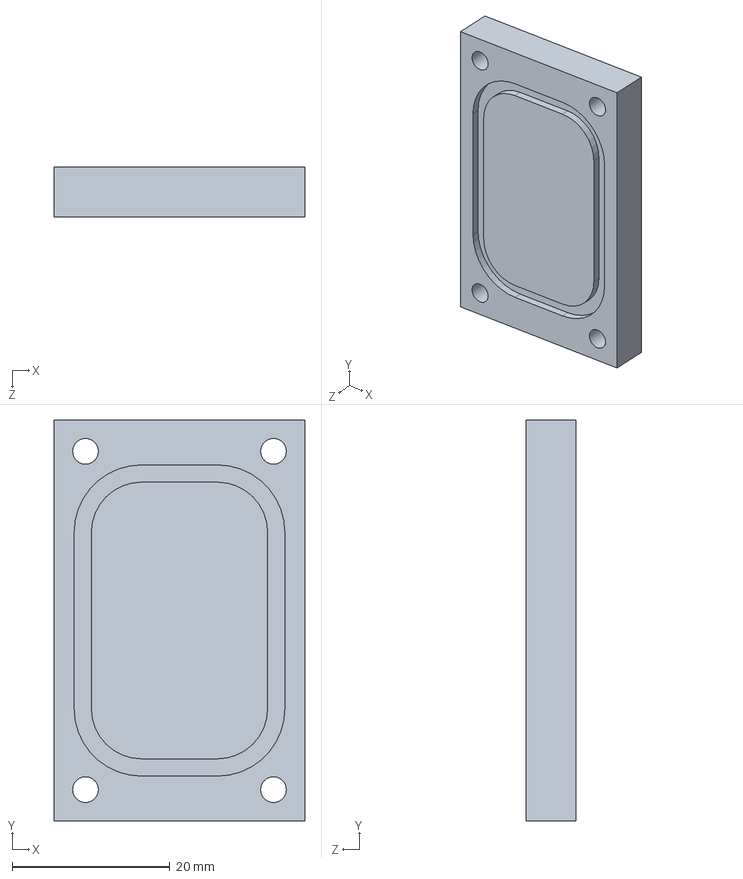
[picture p37: CAD file, 2022-06-01]
hardware/parts/reel_housing_blank.SLDPRT
31.8 x 50.8 x 6.35 mm
