Songyang-W/GridTapeStage_Scatha/hardware/parts/tension_roller_mount_v2.SLDPRT

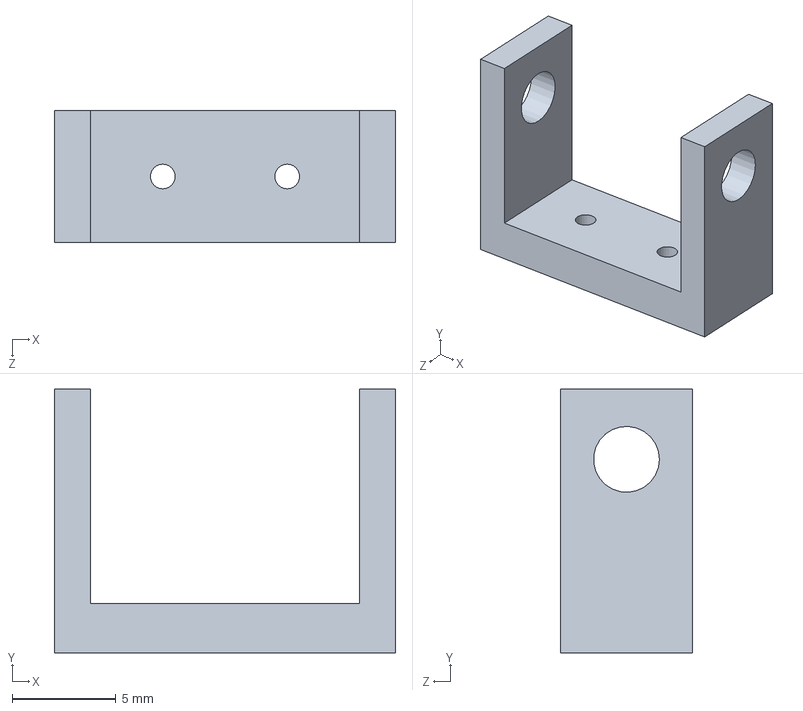
[picture p38: CAD file, 2022-06-01]
hardware/parts/tension_roller_mount_v2.SLDPRT
16.4 x 12.7 x 6.35 mm
