Songyang-W/GridTapeStage_Scatha/hardware/parts/chamber_lid_with_view.SLDPRT

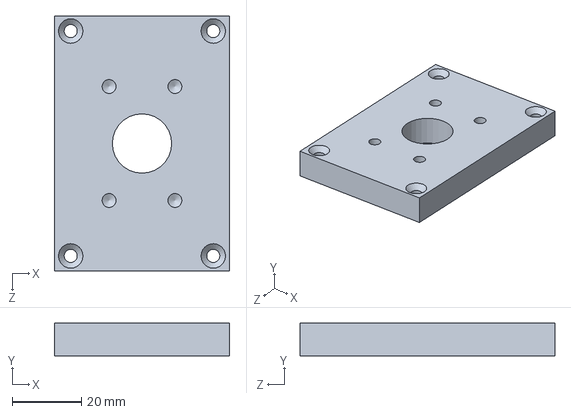
[picture p39: CAD file, 2022-06-01]
hardware/parts/chamber_lid_with_view.SLDPRT
50.8 x 9.53 x 73.8 mm
