Songyang-W/GridTapeStage_Scatha/hardware/parts/reel_door.SLDPRT

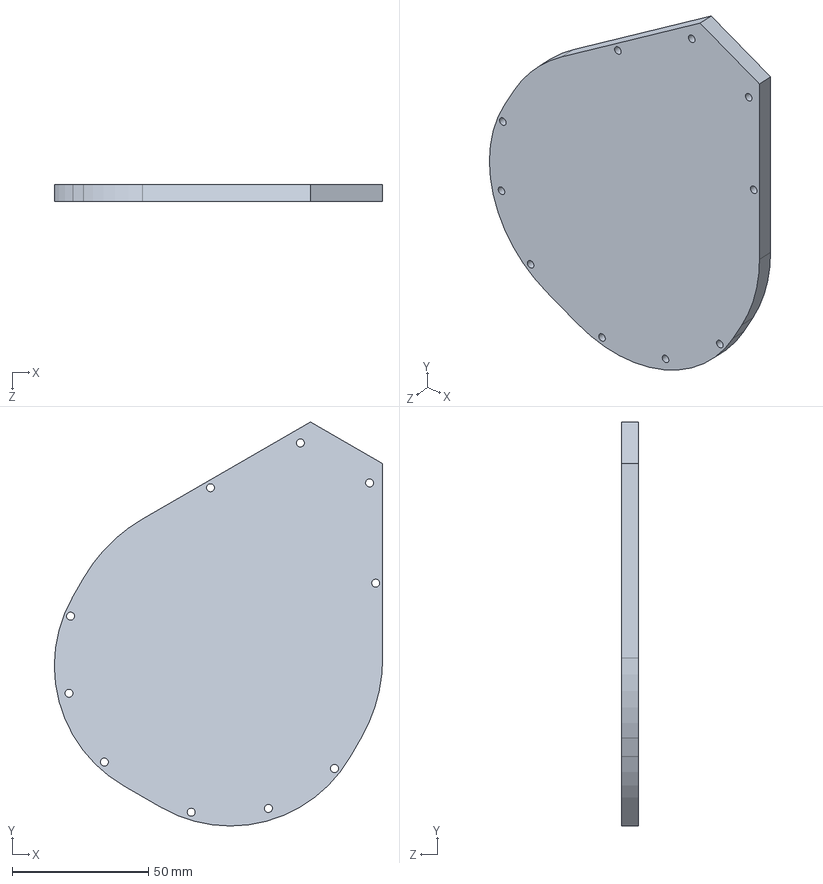
[picture p40: CAD file, 2022-06-01]
hardware/parts/reel_door.SLDPRT
120.4 x 148.1 x 6.35 mm
