Songyang-W/GridTapeStage_Scatha/hardware/parts/takeup_reel_flange.SLDPRT

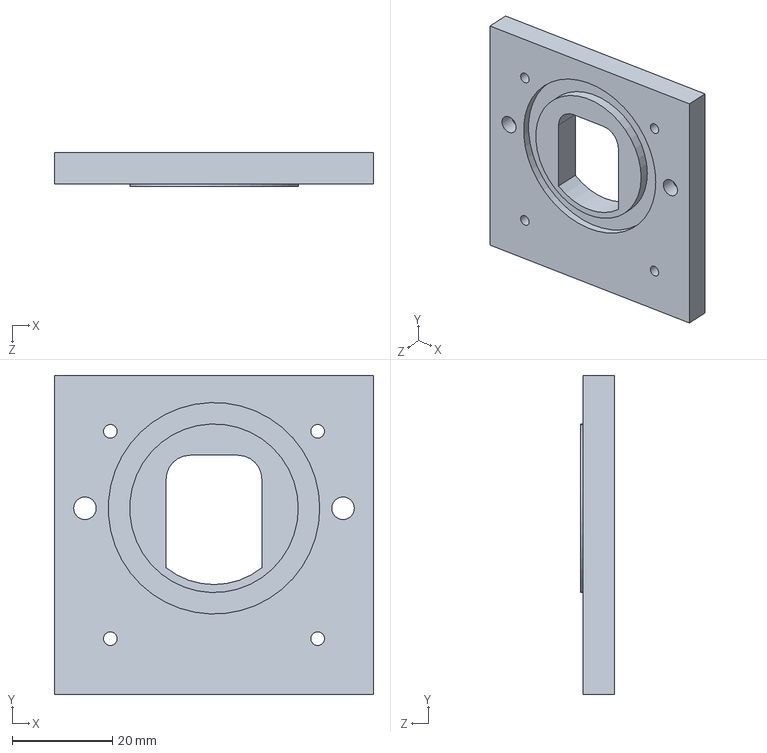
[picture p41: CAD file, 2022-06-01]
hardware/parts/takeup_reel_flange.SLDPRT
63.5 x 63.5 x 6.86 mm
