Songyang-W/GridTapeStage_Scatha/hardware/parts/ferrotec_clamp.SLDPRT

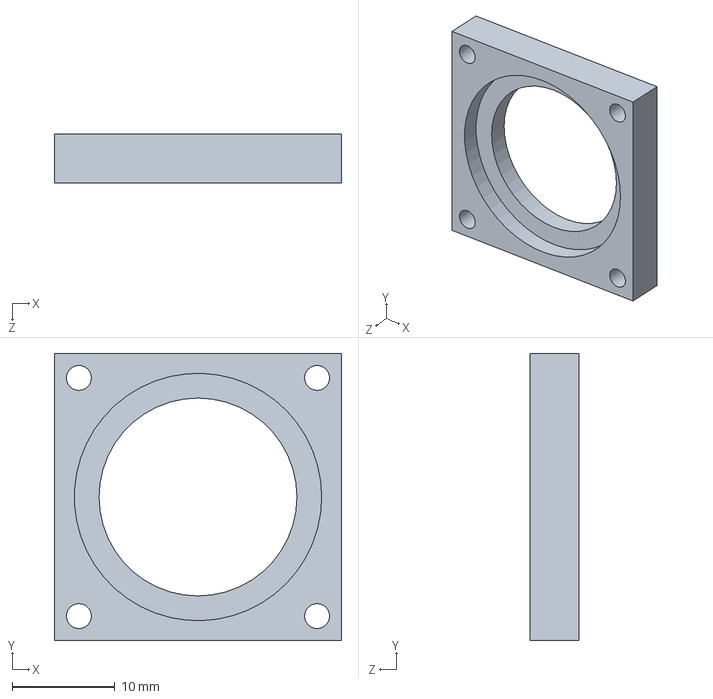
[picture p42: CAD file, 2022-06-01]
hardware/parts/ferrotec_clamp.SLDPRT
28.0 x 28.0 x 4.76 mm
