Songyang-W/GridTapeStage_Scatha/hardware/parts/tc_led_mount.SLDPRT

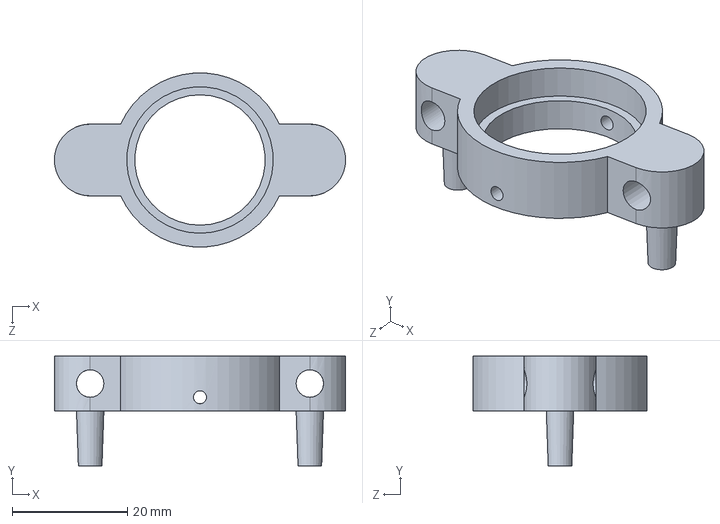
[picture p43: CAD file, 2022-06-01]
hardware/parts/tc_led_mount.SLDPRT
50.5 x 19.1 x 30.2 mm
