Songyang-W/GridTapeStage_Scatha/hardware/parts/takeup_rest_insert.SLDPRT

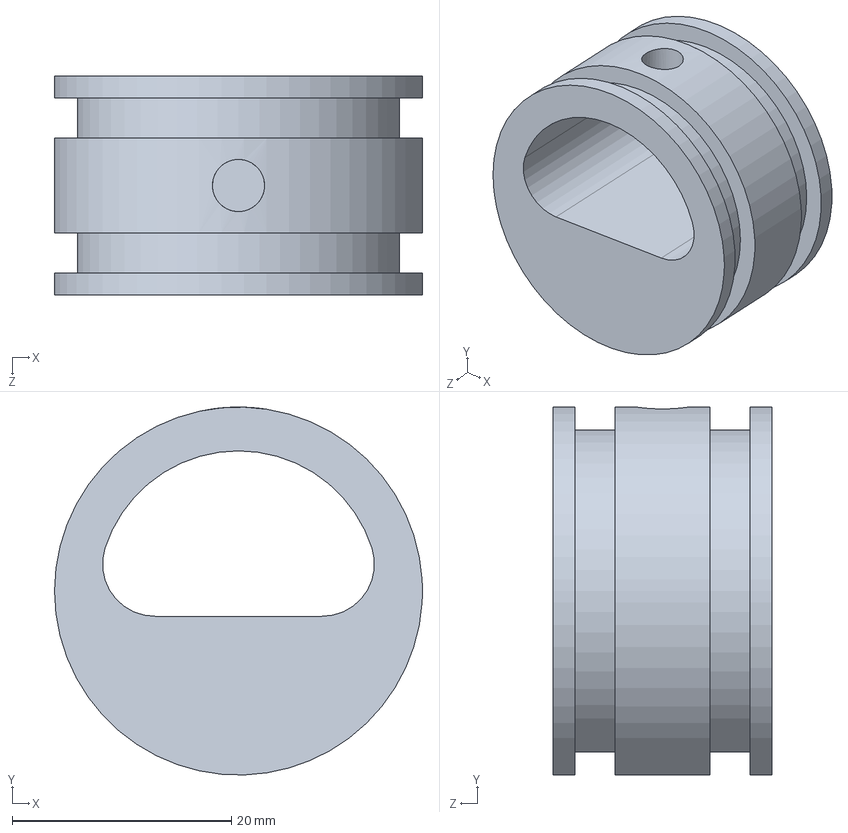
[picture p44: CAD file, 2022-06-01]
hardware/parts/takeup_rest_insert.SLDPRT
33.6 x 33.6 x 20.0 mm
