Songyang-W/GridTapeStage_Scatha/hardware/parts/inner_spacer.SLDPRT

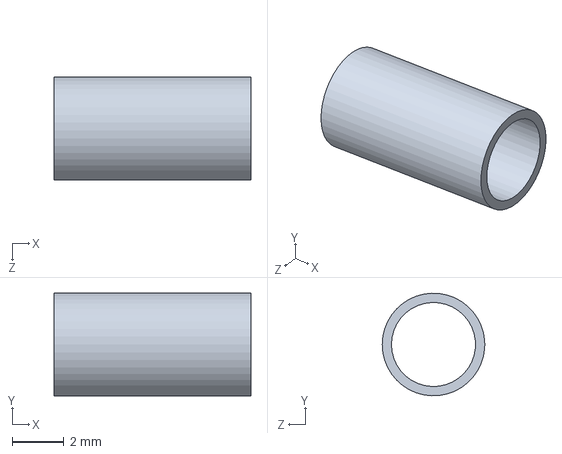
[picture p45: CAD file, 2022-06-01]
hardware/parts/inner_spacer.SLDPRT
7.62 x 3.97 x 3.97 mm
