Songyang-W/GridTapeStage_Scatha/hardware/parts/other/spring_clamp.SLDPRT

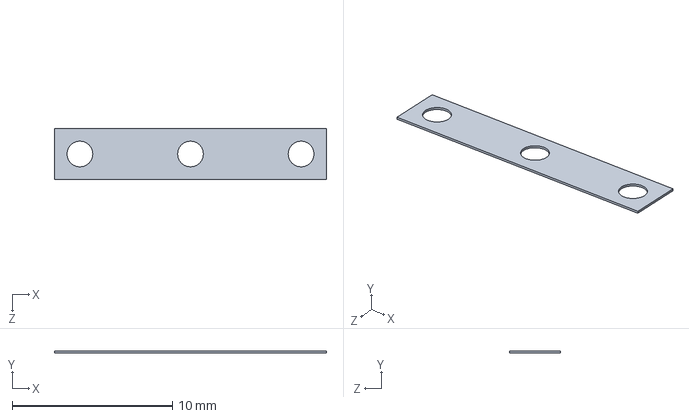
[picture p46: CAD file, 2022-06-01]
hardware/parts/other/spring_clamp.SLDPRT
17.0 x 0.127 x 3.17 mm
