Songyang-W/GridTapeStage_Scatha/hardware/parts/straight_stick_v2.SLDPRT

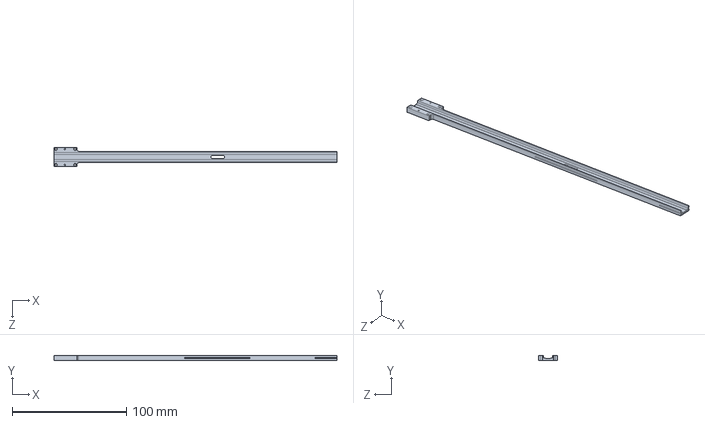
[picture p47: CAD file, 2022-06-01]
hardware/parts/straight_stick_v2.SLDPRT
247.6 x 4.00 x 17.0 mm
