Songyang-W/GridTapeStage_Scatha/hardware/parts/channel_base_plate.sldprt

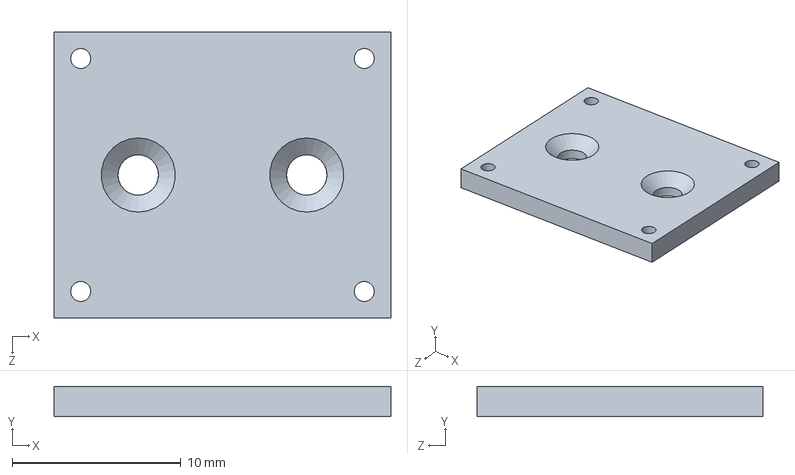
[picture p48: CAD file, 2022-06-01]
hardware/parts/channel_base_plate.sldprt
20.0 x 1.79 x 17.0 mm
