Songyang-W/GridTapeStage_Scatha/hardware/parts/chamber_v1.SLDPRT

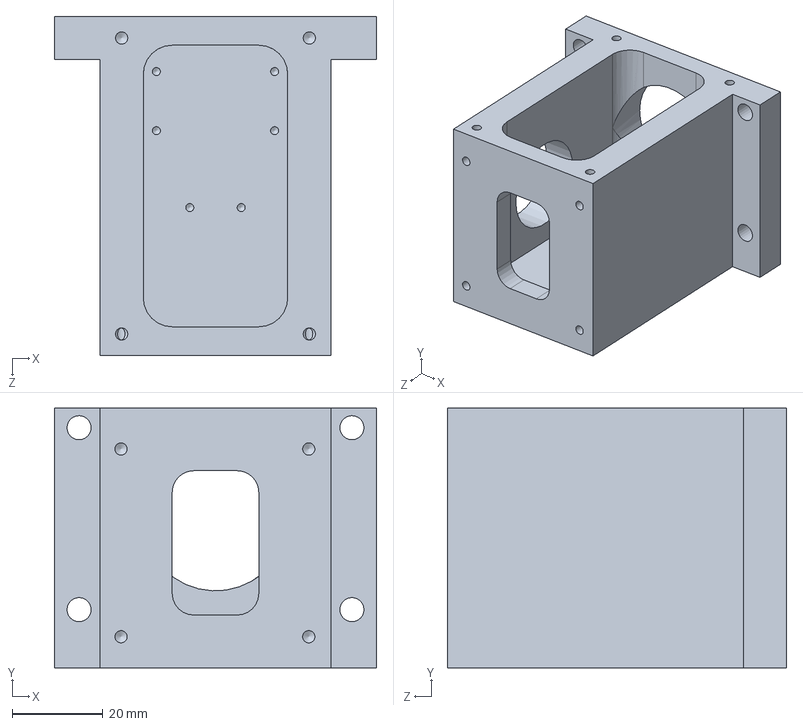
[picture p49: CAD file, 2022-06-01]
hardware/parts/chamber_v1.SLDPRT
70.8 x 57.1 x 74.6 mm
