Songyang-W/GridTapeStage_Scatha/hardware/parts/other/idle_roller_p25in.SLDPRT

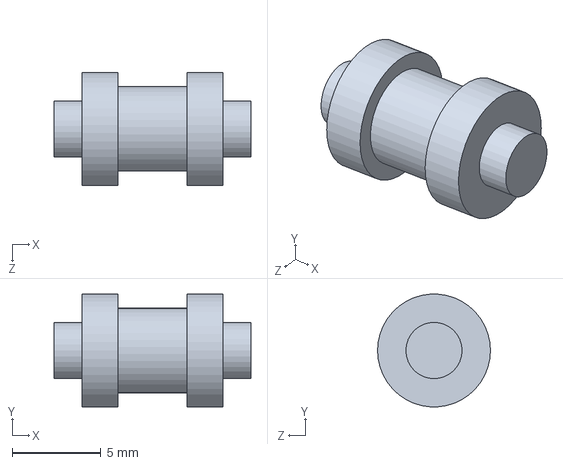
[picture p51: CAD file, 2022-06-01]
hardware/parts/other/idle_roller_p25in.SLDPRT
11.1 x 6.33 x 6.35 mm
