Songyang-W/GridTapeStage_Scatha/hardware/parts/roller_spacer.SLDPRT

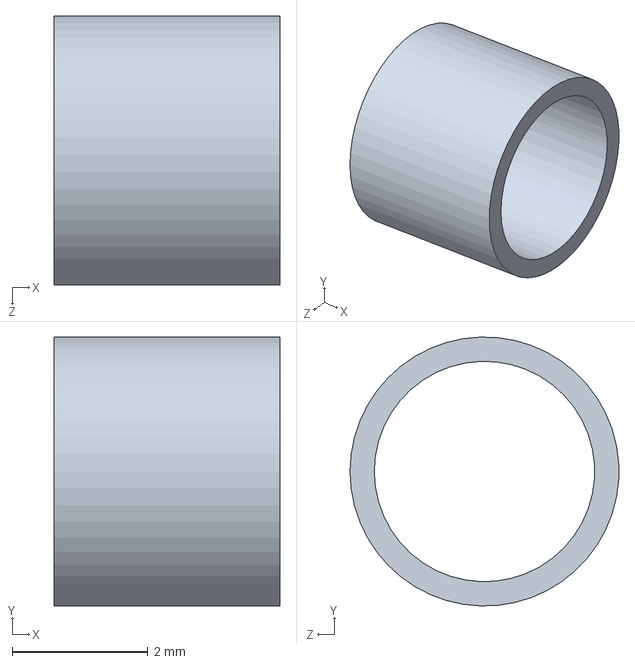
[picture p52: CAD file, 2022-06-01]
hardware/parts/roller_spacer.SLDPRT
3.33 x 3.97 x 3.97 mm
