Songyang-W/GridTapeStage_Scatha/hardware/parts/front_left_xy_flange.SLDPRT

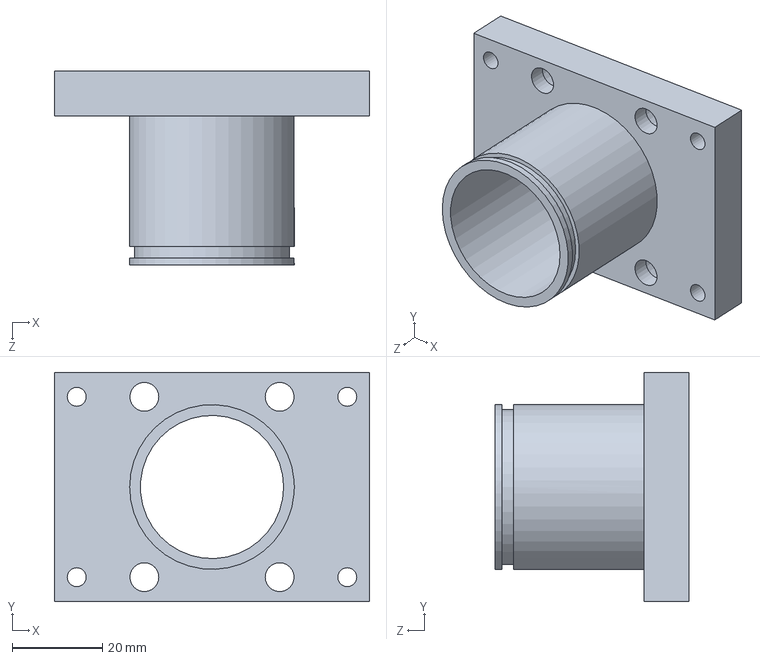
[picture p53: CAD file, 2022-06-01]
hardware/parts/front_left_xy_flange.SLDPRT
69.8 x 50.8 x 43.0 mm
