Songyang-W/GridTapeStage_Scatha/hardware/parts/other/reel_wall.SLDPRT

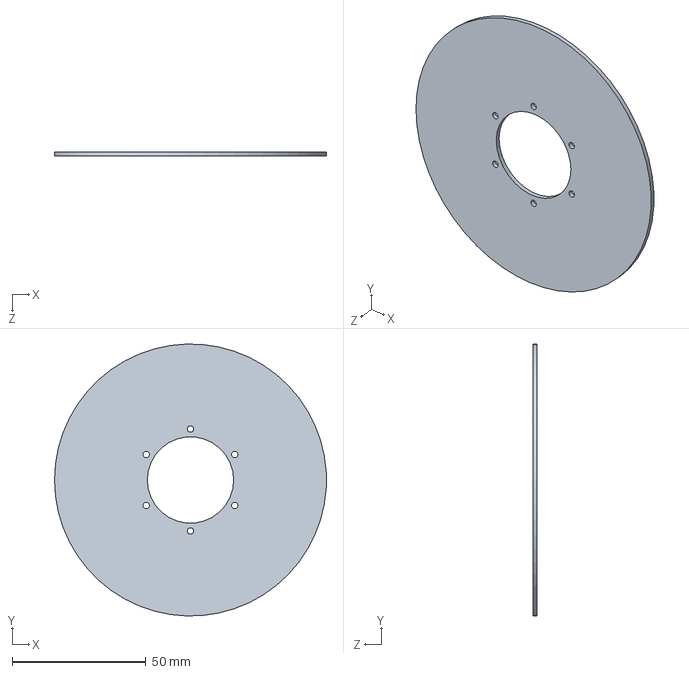
[picture p54: CAD file, 2022-06-01]
hardware/parts/other/reel_wall.SLDPRT
101.6 x 101.6 x 1.59 mm
