Songyang-W/GridTapeStage_Scatha/hardware/parts/reel_drive_clamp_test1.STEP

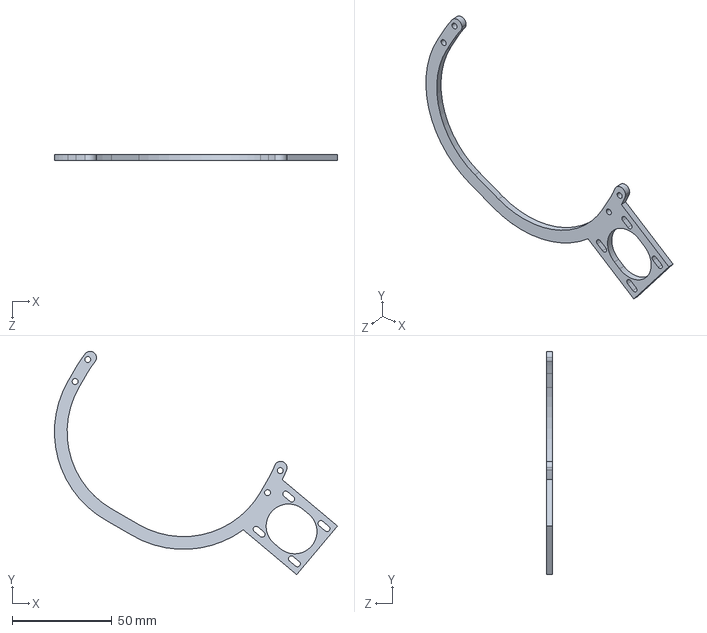
[picture p55: CAD file, 2022-06-01]
hardware/parts/reel_drive_clamp_test1.STEP
141.5 x 111.7 x 3.18 mm
