Songyang-W/GridTapeStage_Scatha/hardware/parts/roller.SLDPRT

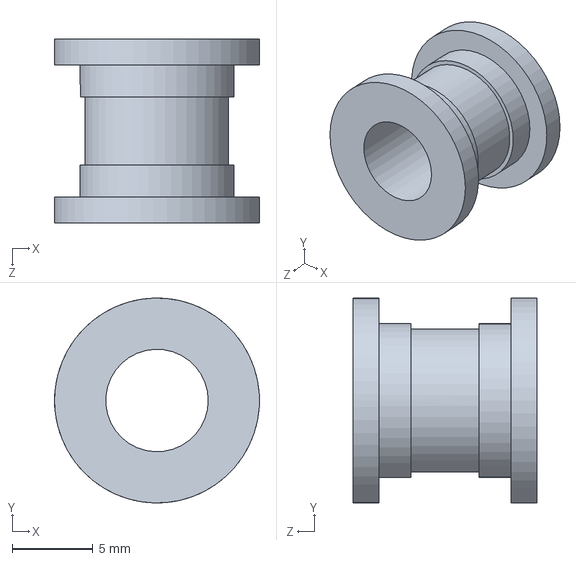
[picture p56: CAD file, 2022-06-01]
hardware/parts/roller.SLDPRT
12.7 x 12.7 x 11.4 mm
