Songyang-W/GridTapeStage_Scatha/hardware/parts/tape_clamp.SLDPRT

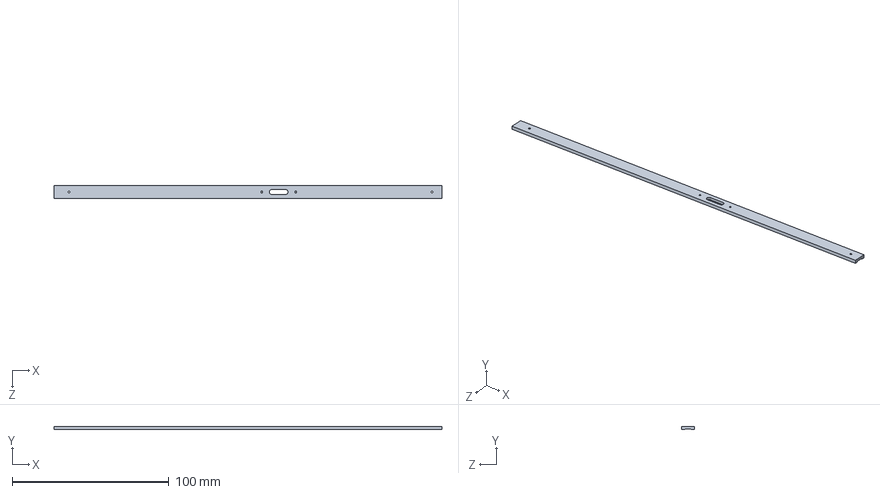
[picture p57: CAD file, 2022-06-01]
hardware/parts/tape_clamp.SLDPRT
247.6 x 2.00 x 8.00 mm
