Songyang-W/GridTapeStage_Scatha/hardware/parts/bandbmnfg_18mp012-6fa2.stp

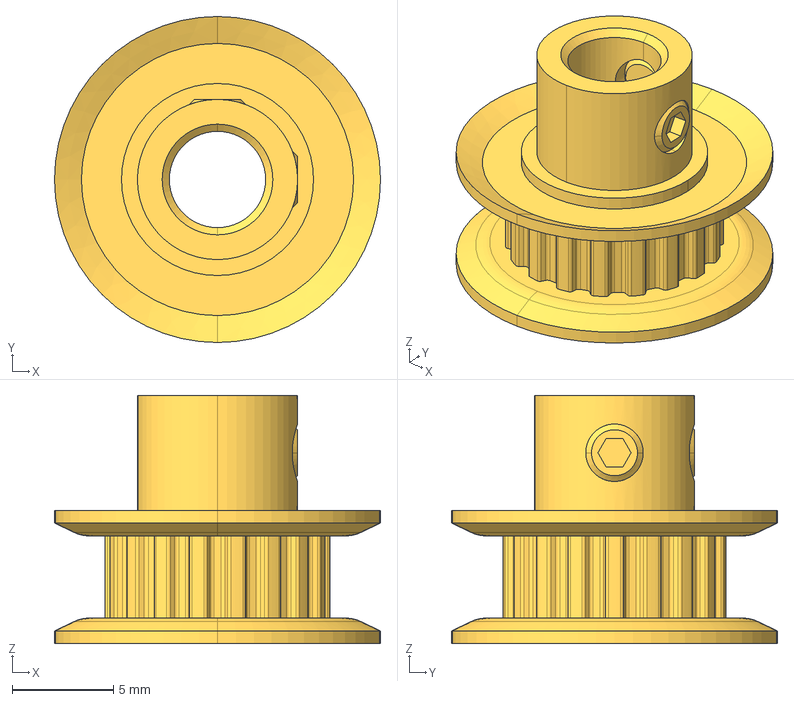
[picture p58: CAD file, 2022-06-01]
hardware/parts/bandbmnfg_18mp012-6fa2.stp
16.1 x 16.1 x 12.3 mm
