Songyang-W/GridTapeStage_Scatha/hardware/parts/other/load_cell_vertical_adapter.SLDPRT

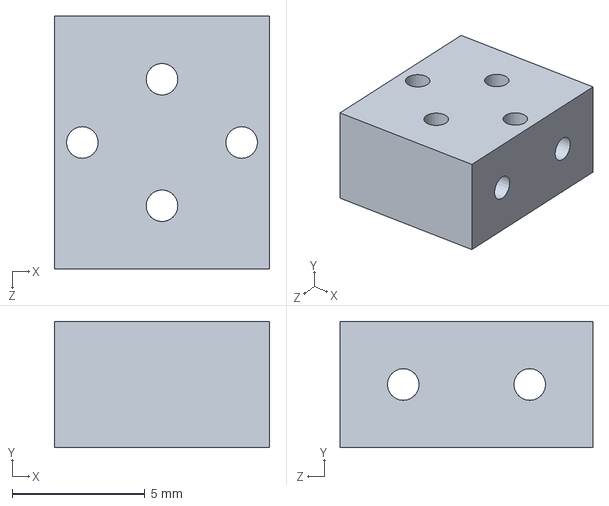
[picture p59: CAD file, 2022-06-01]
hardware/parts/other/load_cell_vertical_adapter.SLDPRT
8.10 x 4.76 x 9.53 mm
