Songyang-W/GridTapeStage_Scatha/hardware/parts/other/nema11.sldprt

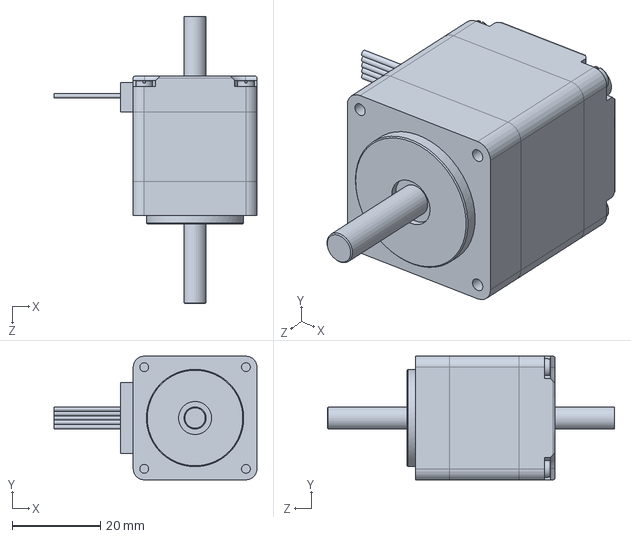
[picture p60: CAD file, 2022-06-01]
hardware/parts/other/nema11.sldprt
45.9 x 28.0 x 65.0 mm
