Songyang-W/GridTapeStage_Scatha/hardware/parts/other/mxl_15t_3f16b_1375K15.SLDPRT

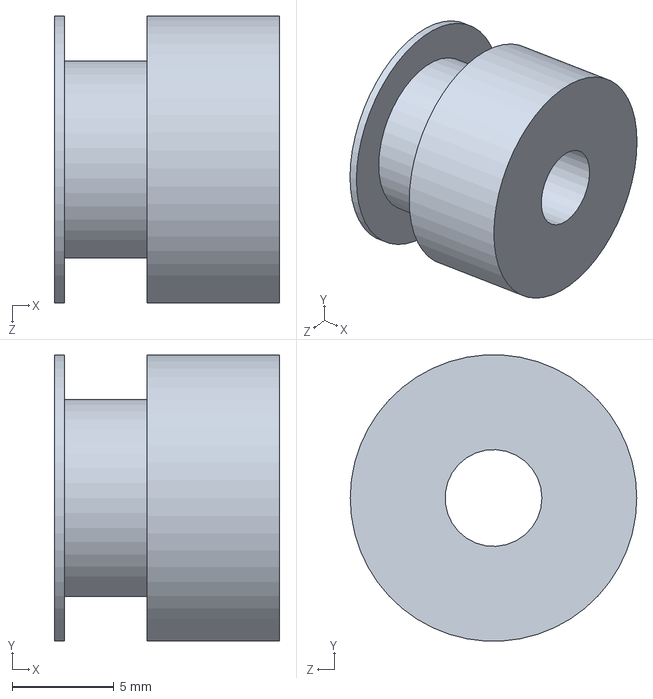
[picture p61: CAD file, 2022-06-01]
hardware/parts/other/mxl_15t_3f16b_1375K15.SLDPRT
11.1 x 14.1 x 14.1 mm
