Songyang-W/GridTapeStage_Scatha/(list of files, cad)

Other CAD files:
hardware/parts/other/aperture_objective.sldasm
hardware/parts/other/Ferrotec SS-188-SLEX (103073).sldasm
hardware/parts/other/JEOL 1200ex OL Module_SAP Polepiece column.sldasm
hardware/parts/other/right_side_solenoid.sldprt
hardware/parts/other/QF16-075-BC-R_2.sldprt
hardware/parts/other/QF16-075-BC-R_3.sldprt
hardware/parts/other/1_2.sldprt
hardware/parts/mouse.stp
hardware/parts/drive_roller_smaller.SLDPRT
hardware/parts/other/sap.sldprt
hardware/parts/other/goniometer_2.sldprt
hardware/parts/other/1_3.sldprt
hardware/parts/other/Aperture blade.sldprt
hardware/parts/other/goniometer.sldprt
hardware/parts/other/SI_sdpsi_s98ca6-mec160417.stp
hardware/parts/other/JEOL 1200EX OL Module Rev. B.sldprt
hardware/parts/other/aperture_objective_plate.sldprt
hardware/drawings/1375K17_MXL Series Timing Belt Pulley.SLDDRW
hardware/drawings/SI_sdpsi_s98ca6-mec160417.SLDDRW
hardware/drawings/chamber_lid_with_view.SLDDRW
hardware/drawings/chamber_v1.SLDDRW
hardware/drawings/channel_base_plate.SLDDRW
hardware/drawings/drive_roller.SLDDRW
hardware/drawings/ferrotec_clamp.SLDDRW
hardware/drawings/front_left_xy_flange.SLDDRW
hardware/drawings/load_cell_vertical_base_v2.SLDDRW
hardware/drawings/piezo_baseplate.SLDDRW
hardware/drawings/reel_adapter_screw_set_3f16.SLDDRW
hardware/drawings/reel_door.SLDDRW
hardware/drawings/reel_housing.SLDDRW
hardware/drawings/reel_housing_blank.SLDDRW
hardware/drawings/reel_housing_flange.SLDDRW
hardware/drawings/reel_housing_to_qf16_flange.SLDDRW
hardware/drawings/roller.SLDDRW
hardware/drawings/shaft_adapter_5mm_1f4in.SLDDRW
hardware/drawings/straight_stick_v2.SLDDRW
hardware/drawings/takeup_reel_flange.SLDDRW
hardware/drawings/takeup_rest_insert.SLDDRW
hardware/drawings/tape_clamp.SLDDRW
hardware/drawings/tension_roller_mount_v2.SLDDRW
hardware/drawings/tension_roller_v2.SLDDRW
hardware/parts/SI_sdpsi_s98ca6-mec160417.SLDDRW
hardware/parts/bandbmnfg_18mp012-6fa2.SLDPRT
hardware/parts/other/100517 render.sldprt
hardware/parts/other/101649 render.sldprt
hardware/parts/other/101920 render.sldprt
hardware/parts/other/116906 render.sldprt
hardware/parts/other/1375K17_MXL Series Timing Belt Pulley.SLDPRT
hardware/parts/other/57155K205.SLDPRT
hardware/parts/other/7717N24_MXL Series Lightweight Timing Belt Pulley.SLDPRT
hardware/parts/other/C0001197.sldprt
hardware/parts/other/P0001219.sldprt
hardware/parts/other/P0001498.sldprt
hardware/parts/other/P0017967.sldprt
hardware/parts/reel_adapter_screw_set_3f16.SLDPRT
hardware/parts/reel_drive_clamp.SLDDRW
hardware/parts/reel_drive_clamp.SLDPRT
hardware/parts/reel_drive_clamp.STL
hardware/parts/reel_drive_clamp.ipt
hardware/parts/reel_drive_clamp_test1.SLDPRT
hardware/parts/reel_drive_clamp_test1.STL
hardware/parts/reel_drive_clamp_test2.SLDPRT
hardware/parts/reel_drive_clamp_test2.STL
hardware/parts/reel_drive_clamp_test3.SLDPRT
hardware/parts/reel_drive_clamp_test3.STL
hardware/parts/reel_drive_clamp_test4.SLDPRT
hardware/parts/reel_drive_clamp_test4.STL
hardware/parts/reel_housing_to_qf16_flange.SLDPRT
hardware/parts/shaft_adapter_5mm_1f4in.SLDDRW
hardware/parts/shaft_adapter_5mm_1f4in.SLDPRT
hardware/parts/shaft_adapter_5mm_1f4in.STL
hardware/parts/shaft_adapter_5mm_1f4in.ipt
