Songyang-W/GridTapeStage_Scatha/hardware/pdf/MXL Series Timing Belt Pulley.pdf

6

5

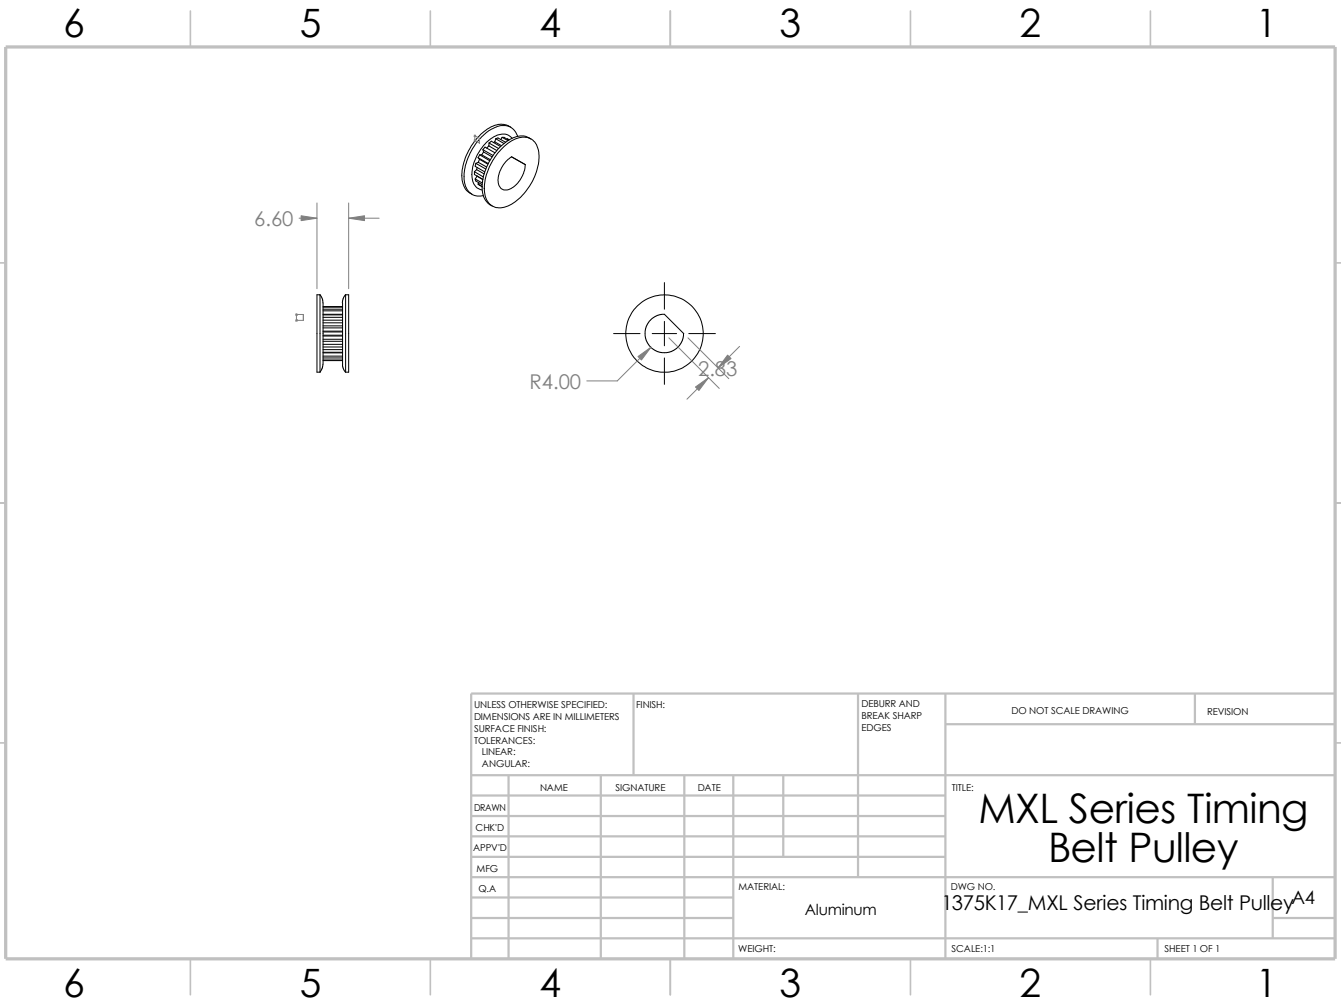
[picture p71: page 1]
BREAK SHARP; WEIGHT:; SHEET 1 OF 1; FINISH:; EDGES; DO NOT SCALE DRAWING; REVISION; SCALE:1:1; DEBURR AND

UNLESS OTHERWISE SPECIFIED:
DIMENSIONS ARE IN MILLIMETERS
SURFACE FINISH:
TOLERANCES:
LINEAR:
ANGULAR:

NAME | SIGNATURE | DATE | | | | TITLE: MXL Series Timing Belt Pulley

DRAWN
CHK'D
APPV'D

MFG
Q.A | | | | MATERIAL: Aluminum 1375K17_MXL Series Timing Belt Pulley | DWG NO. | A4
