Songyang-W/GridTapeStage_Scatha/hardware/pdf/shaft_adapter_5mm_1f4in.pdf

6

5

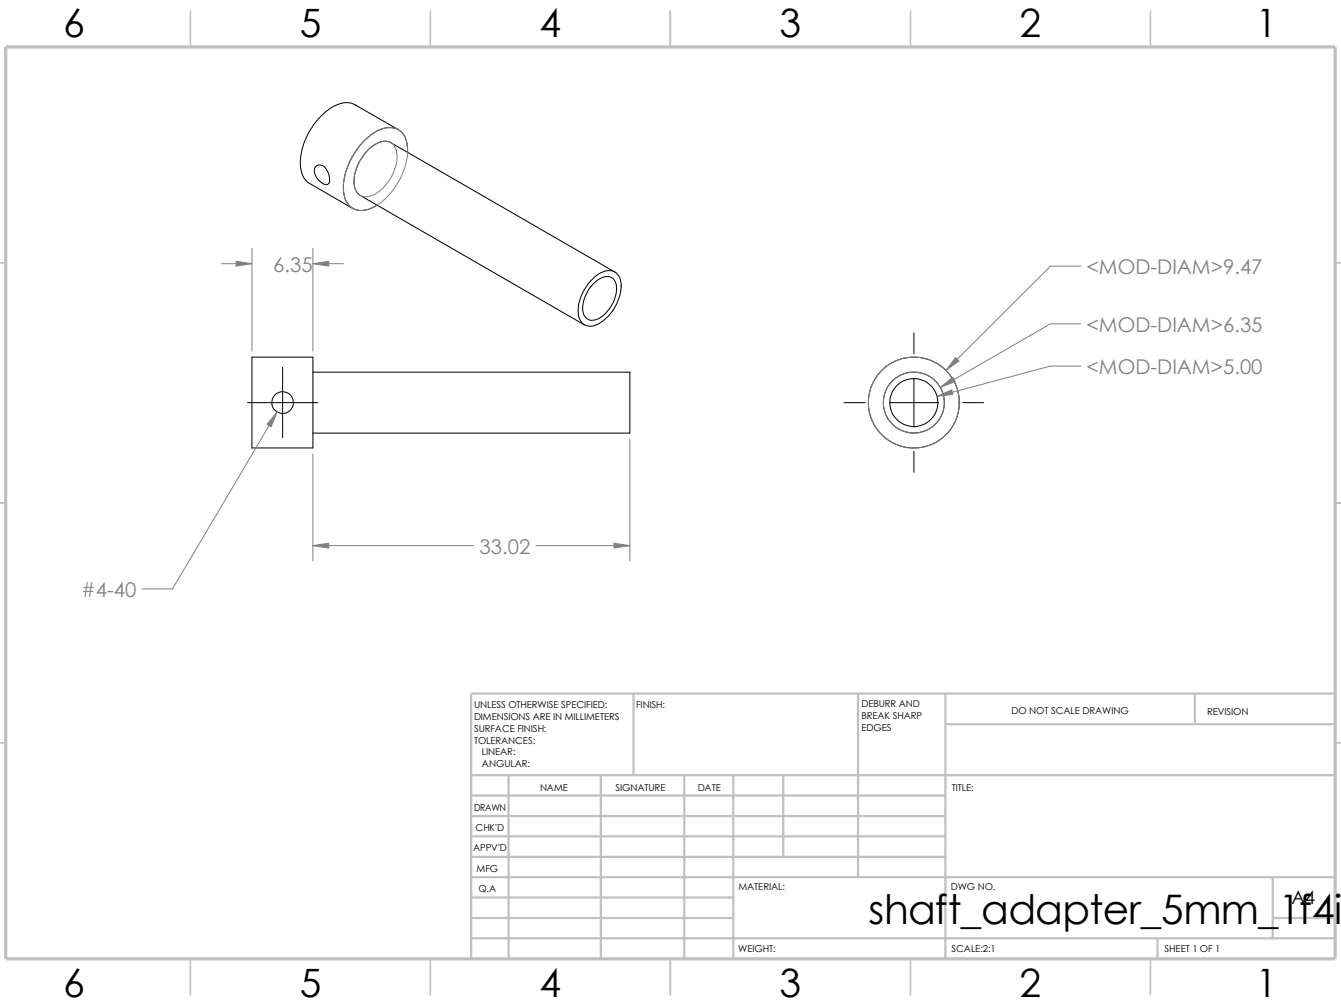
[picture p72: page 1]
WEIGHT:; SCALE:2:1; SHEET 1 OF 1; REVISION; FINISH:; EDGES; DEBURR AND BREAK SHARP; shaft_adapter_5mm_1f4in; <MOD-DIAM>5.00; <MOD-DIAM>9.47; <MOD-DIAM>6.35

DO NOT SCALE DRAWING UNLESS OTHERWISE SPECIFIED:
DIMENSIONS ARE IN MILLIMETERS
SURFACE FINISH:
TOLERANCES:
LINEAR:
ANGULAR:

NAME | SIGNATURE | DATE | | | | TITLE:

DRAWN
CHK'D
APPV'D
Q.A | | | | MATERIAL: | DWG NO. | A4

MFG
