Songyang-W/GridTapeStage_Scatha/hardware/pdf/SI_sdpsi_s97ca6-mec160417.pdf

6

5

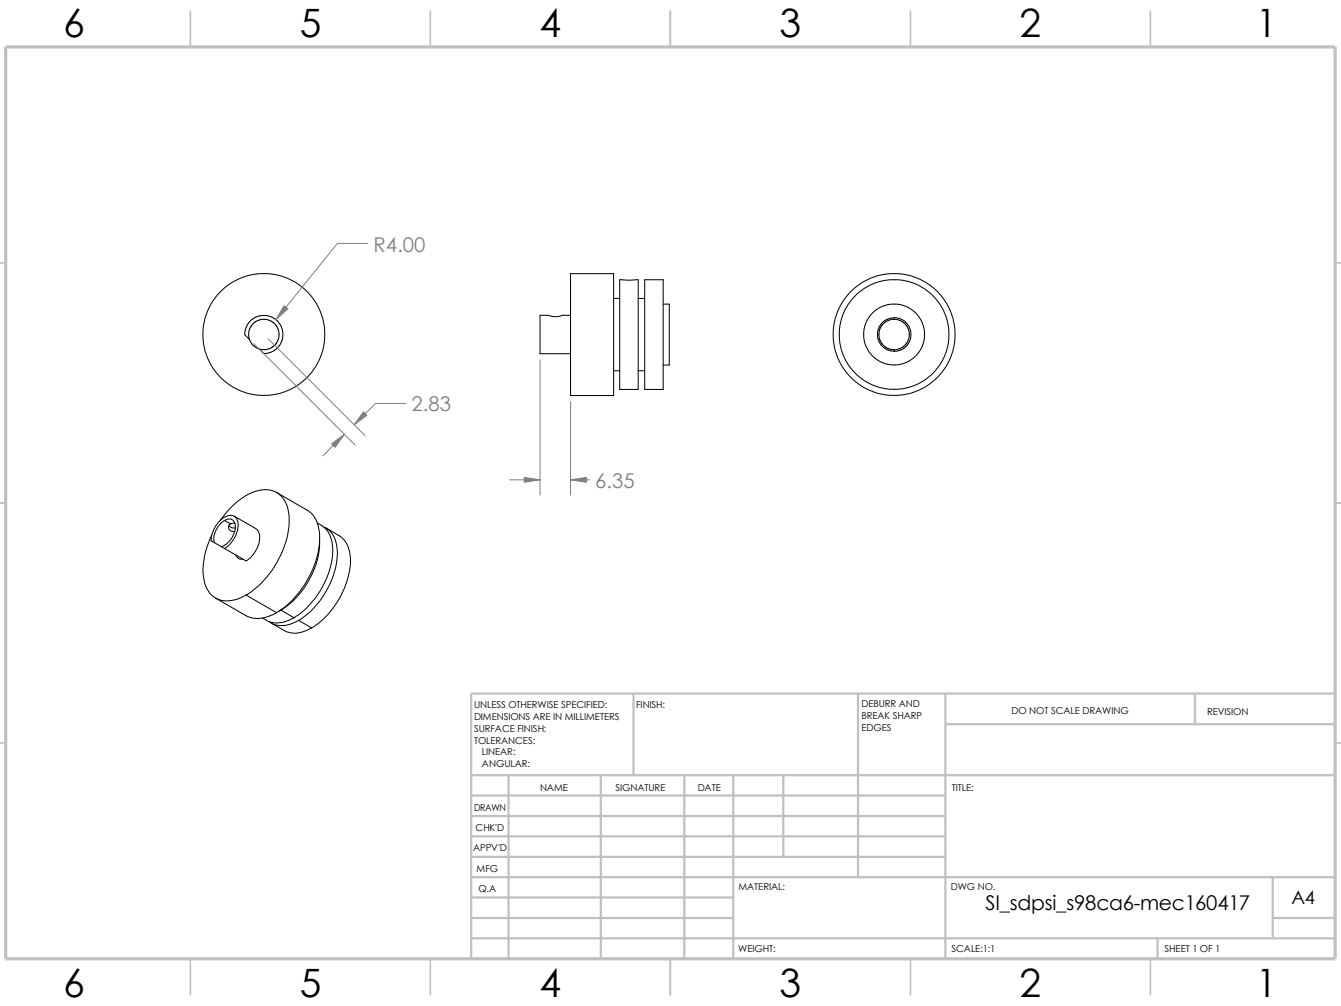
[picture p73: page 1]
WEIGHT:; SCALE:1:1; SHEET 1 OF 1; FINISH:; EDGES; DO NOT SCALE DRAWING; REVISION; DEBURR AND BREAK SHARP

UNLESS OTHERWISE SPECIFIED:
DIMENSIONS ARE IN MILLIMETERS
SURFACE FINISH:
TOLERANCES:
LINEAR:
ANGULAR:

NAME | SIGNATURE | DATE | | | | TITLE:

DRAWN
CHK'D
APPV'D

MFG
Q.A | | | | MATERIAL: | DWG NO. SI_sdpsi_s98ca6-mec160417 | A4
